raulkovcs-ux/emg_iot_device/docs/images/hub_bottom.png

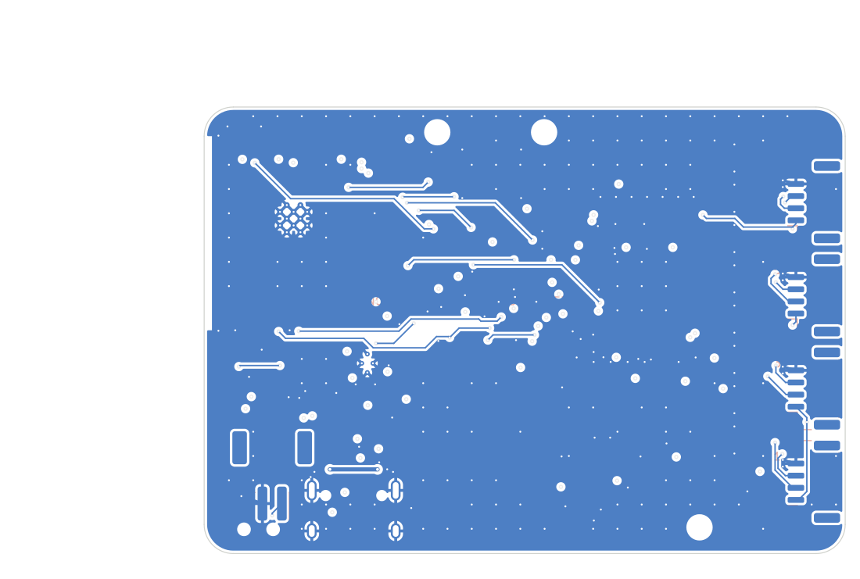
docs/images/hub_bottom.png
