raulkovcs-ux/emg_iot_device/docs/images/hub_flex_bottom.png

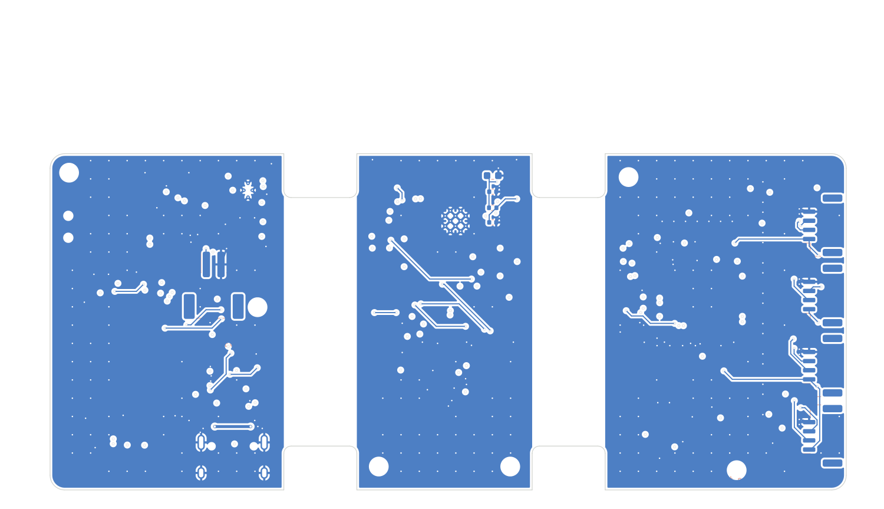
docs/images/hub_flex_bottom.png
