raulkovcs-ux/emg_iot_device/docs/images/hub_flex_schematic-2.png

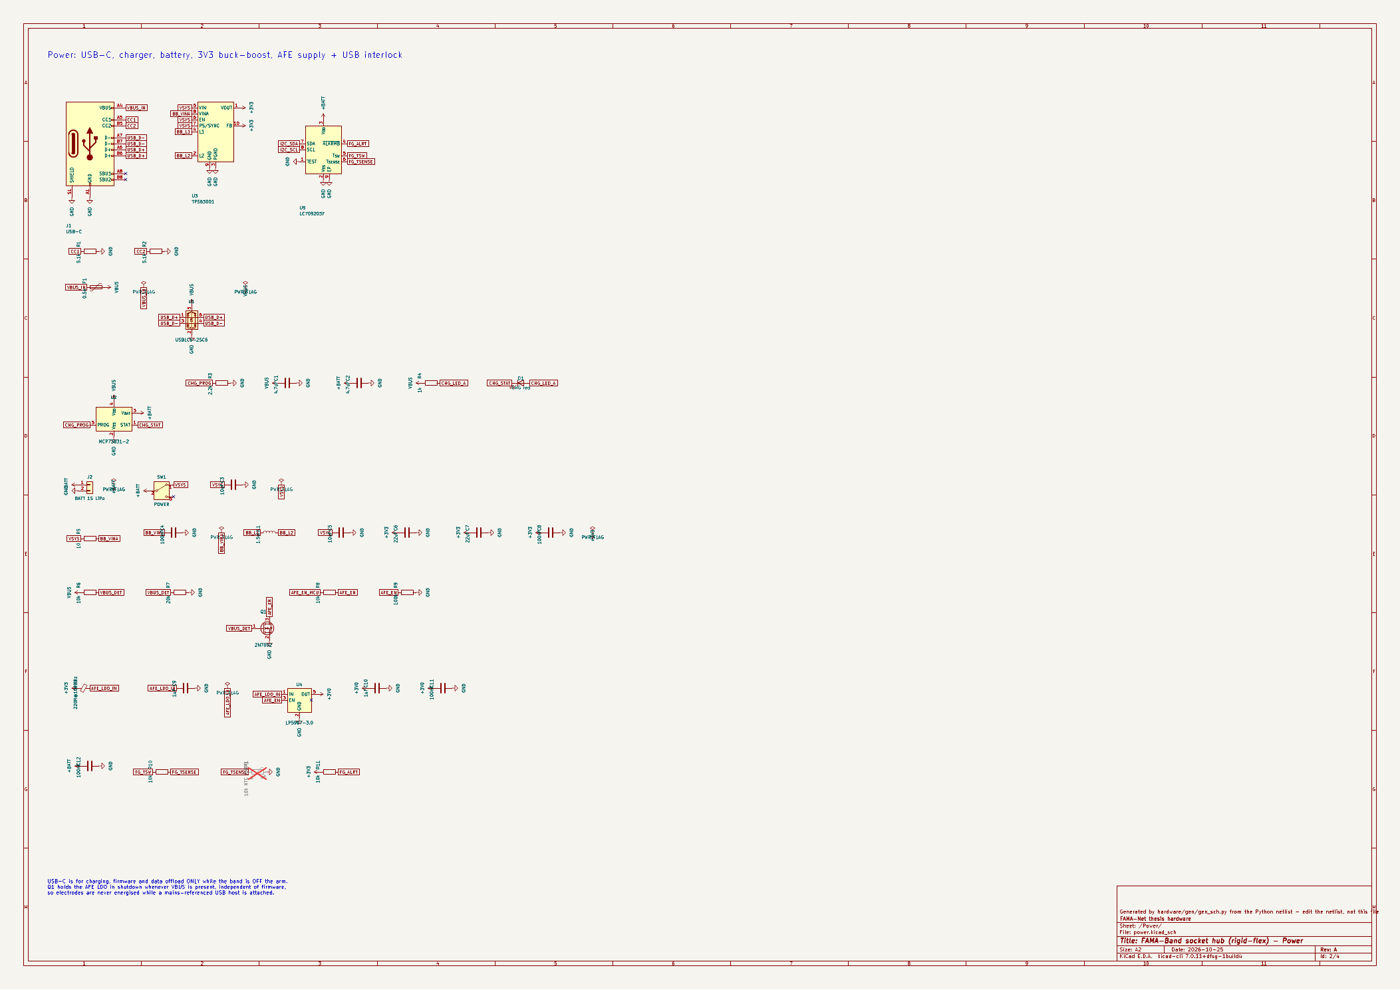
docs/images/hub_flex_schematic-2.png
