raulkovcs-ux/emg_iot_device/docs/images/hub_flex_schematic-3.png

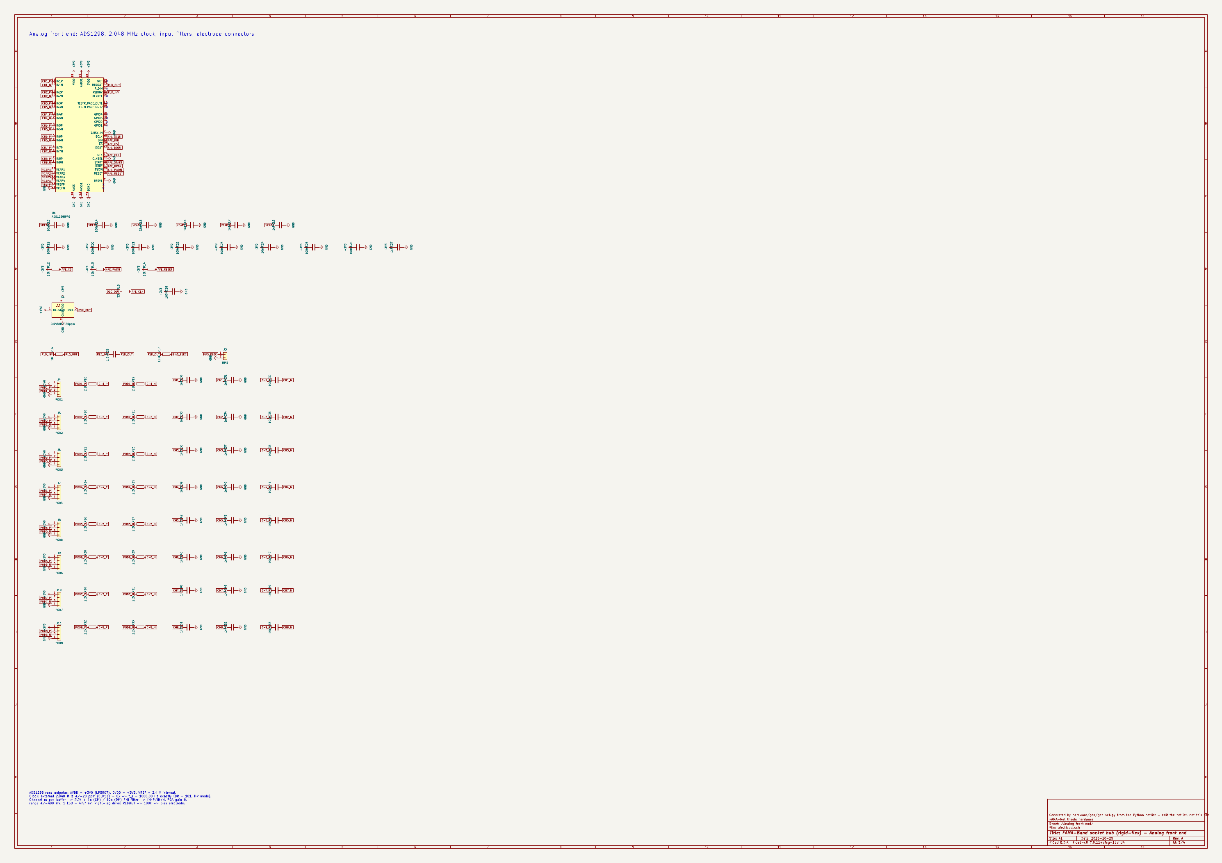
docs/images/hub_flex_schematic-3.png
