raulkovcs-ux/emg_iot_device/docs/images/hub_flex_schematic-4.png

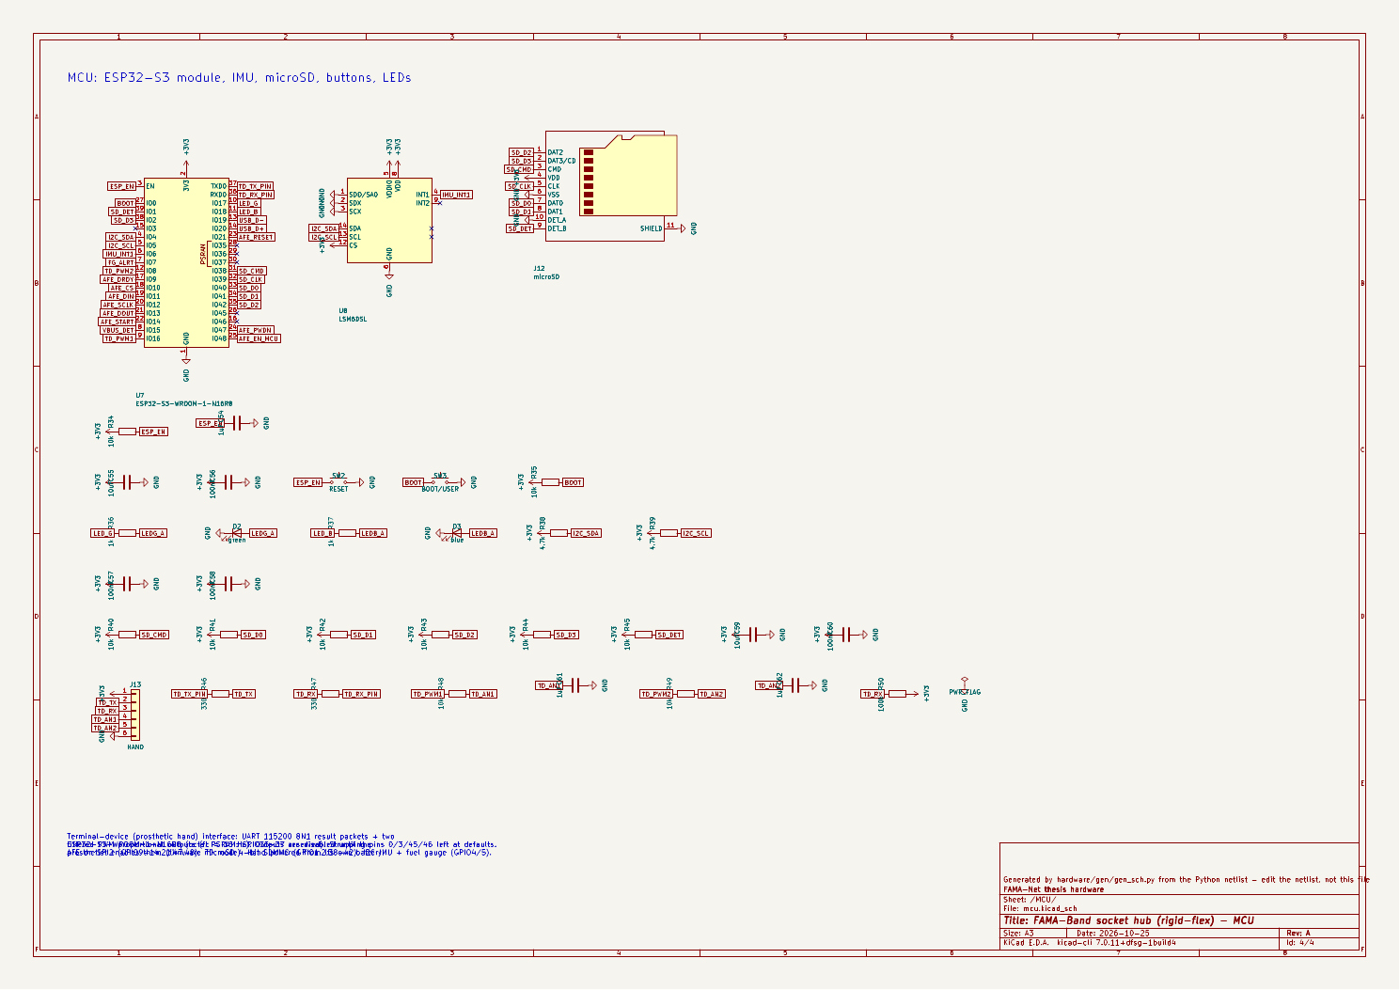
docs/images/hub_flex_schematic-4.png
