raulkovcs-ux/emg_iot_device/docs/images/hub_in2.png

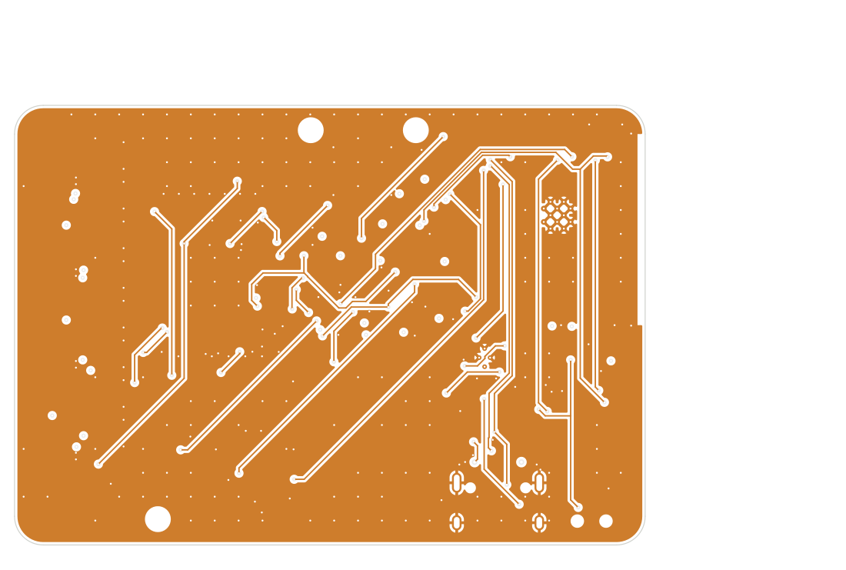
docs/images/hub_in2.png
