raulkovcs-ux/emg_iot_device/docs/images/pod_schematic-1.png

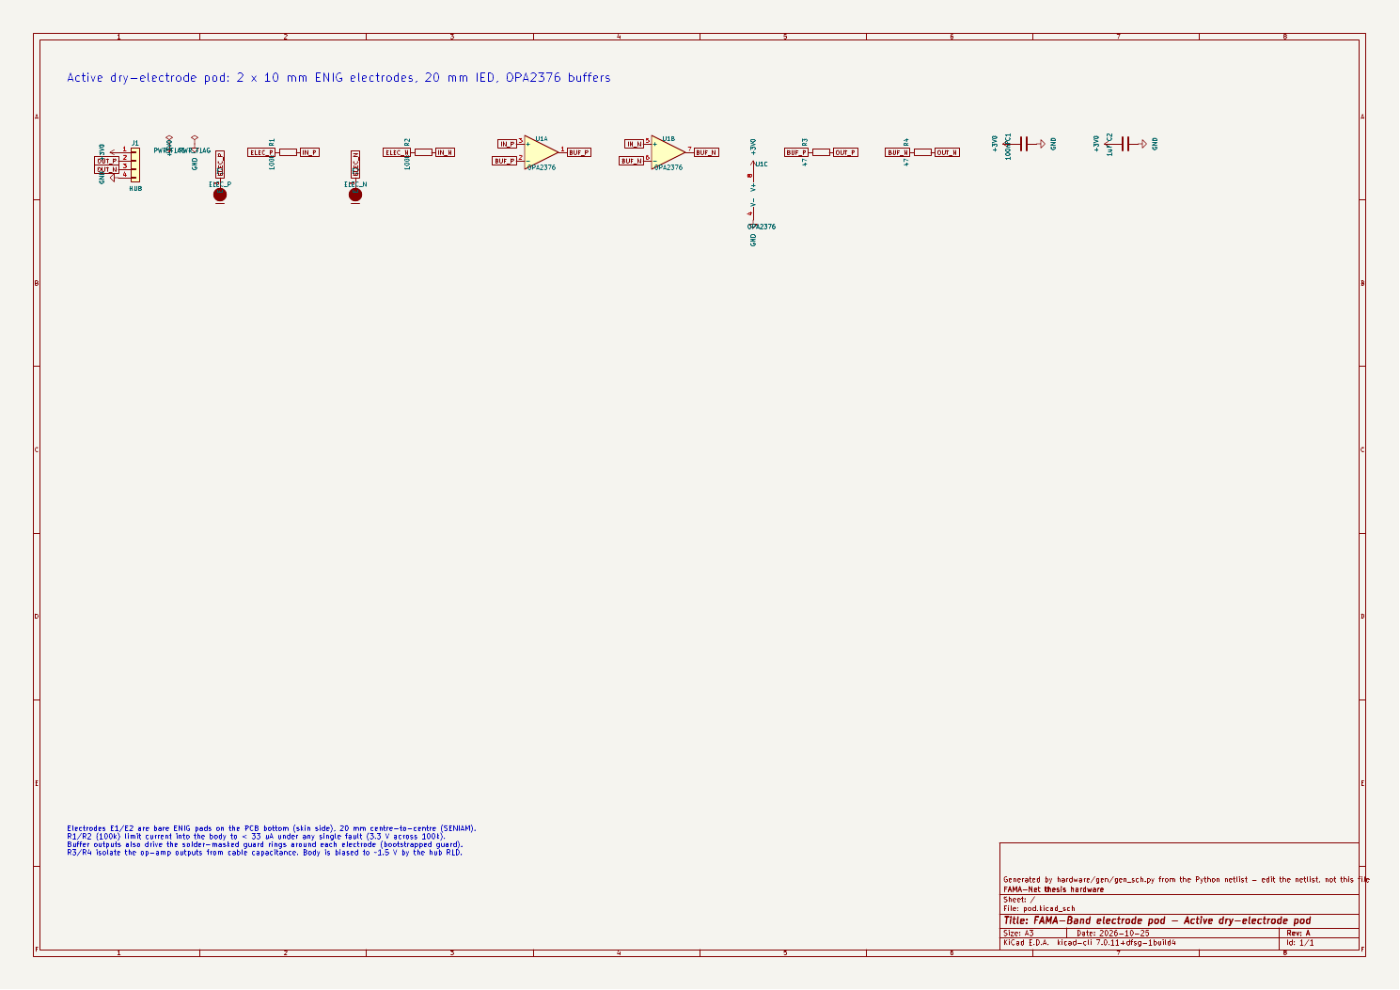
docs/images/pod_schematic-1.png
