raulkovcs-ux/emg_iot_device/docs/images/pod_skin_side.png

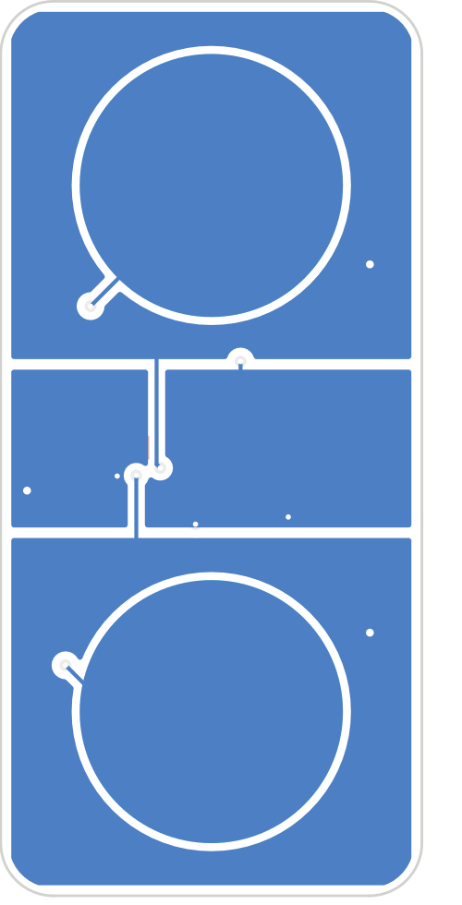
docs/images/pod_skin_side.png
