raulkovcs-ux/emg_iot_device/docs/images/pod_top.png

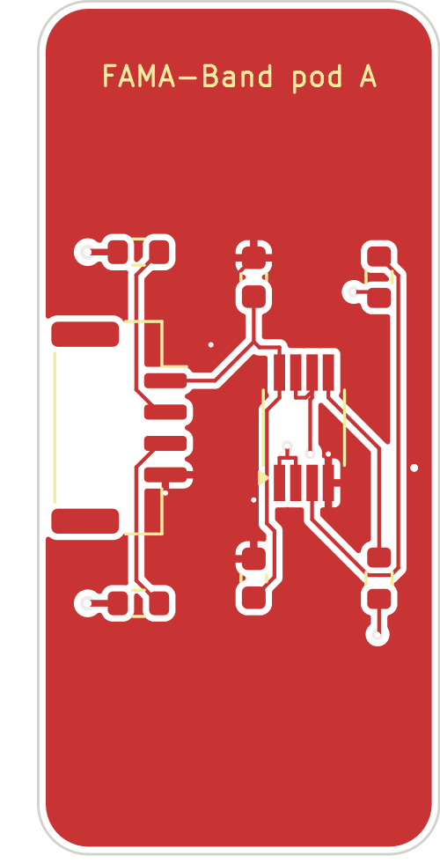
docs/images/pod_top.png
