raulkovcs-ux/emg_iot_device/hardware/fab/hub/hub.step

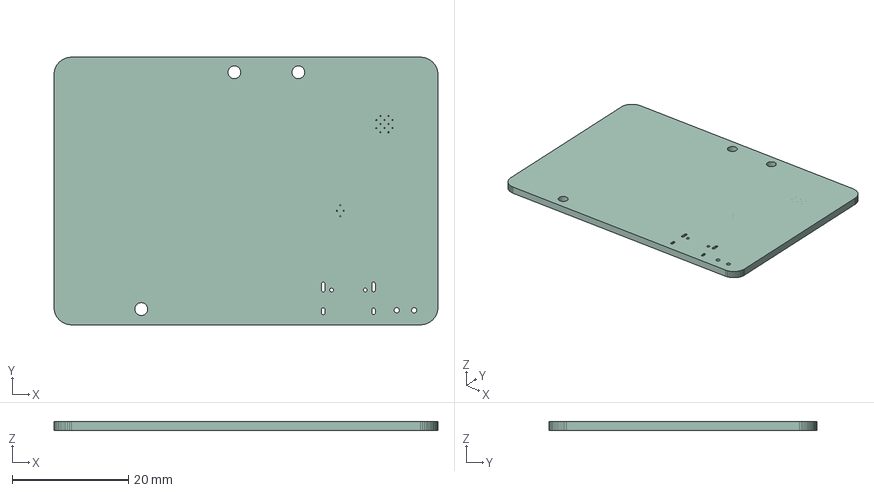
[picture p21: CAD file, 2026-10-24]
hardware/fab/hub/hub.step
66.0 x 46.0 x 1.60 mm
