raulkovcs-ux/emg_iot_device/hardware/fab/hub_flex/hub_flex.step

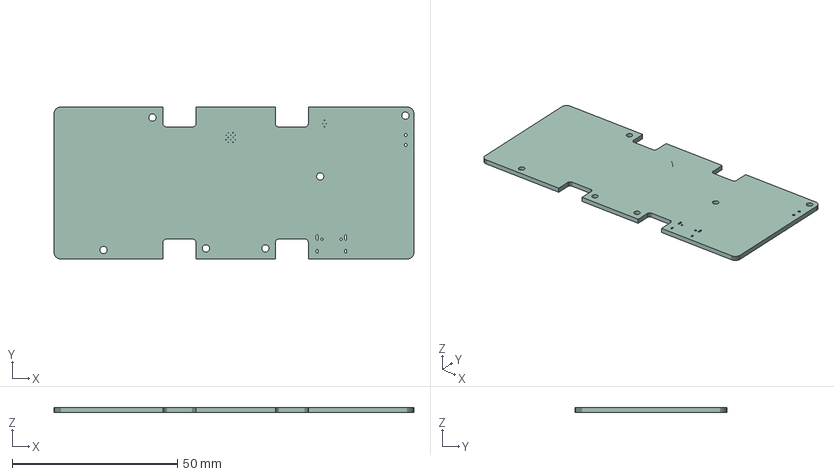
[picture p22: CAD file, 2026-10-25]
hardware/fab/hub_flex/hub_flex.step
109.0 x 46.0 x 1.60 mm
