raulkovcs-ux/emg_iot_device/hardware/fab/pod/pod.step

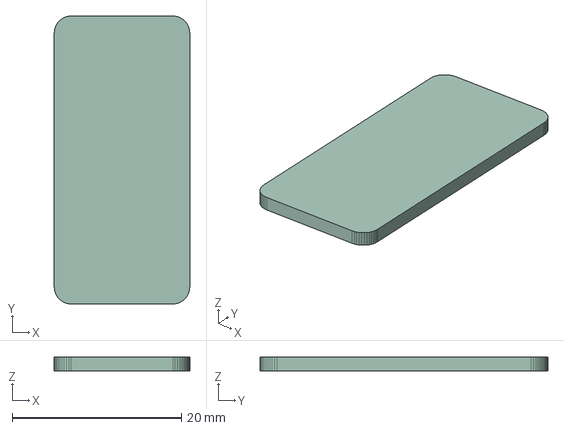
[picture p23: CAD file, 2026-10-24]
hardware/fab/pod/pod.step
16.0 x 34.0 x 1.60 mm
