raulkovcs-ux/emg_iot_device/mechanical/stl/socket_service_door.stl

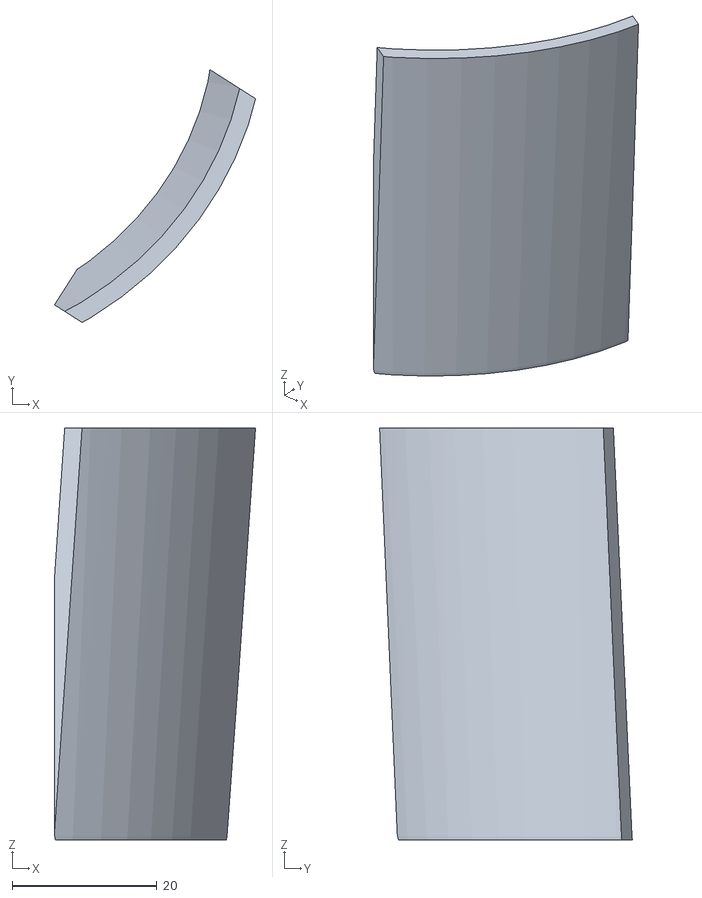
[picture p24: CAD file, 2026-10-25]
mechanical/stl/socket_service_door.stl
27.8 x 35.0 x 57.0
