raulkovcs-ux/emg_iot_device/mechanical/stl/socket_hub_carrier.stl

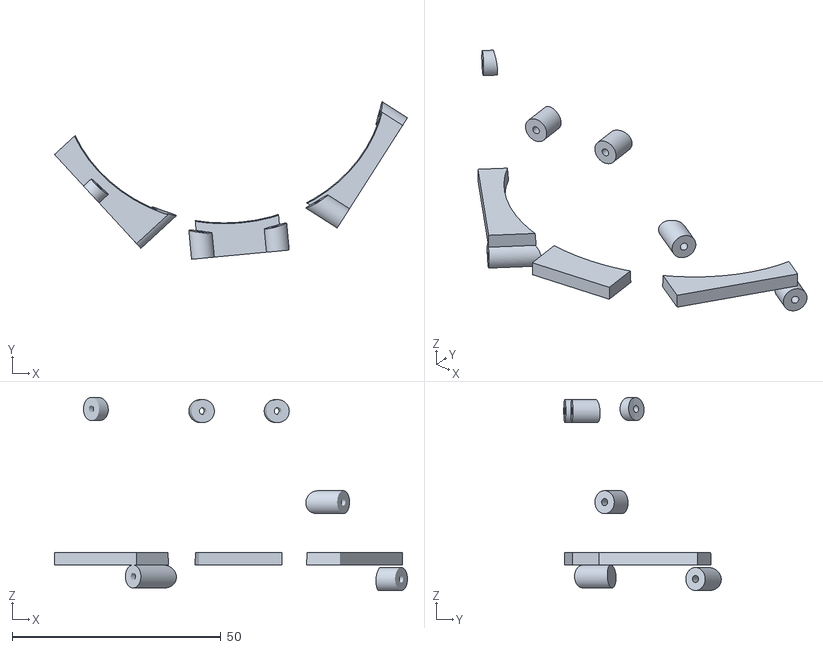
[picture p25: CAD file, 2026-10-25]
mechanical/stl/socket_hub_carrier.stl
84.5 x 37.7 x 46.2
