raulkovcs-ux/emg_iot_device/mechanical/stl/socket_inner_socket.stl

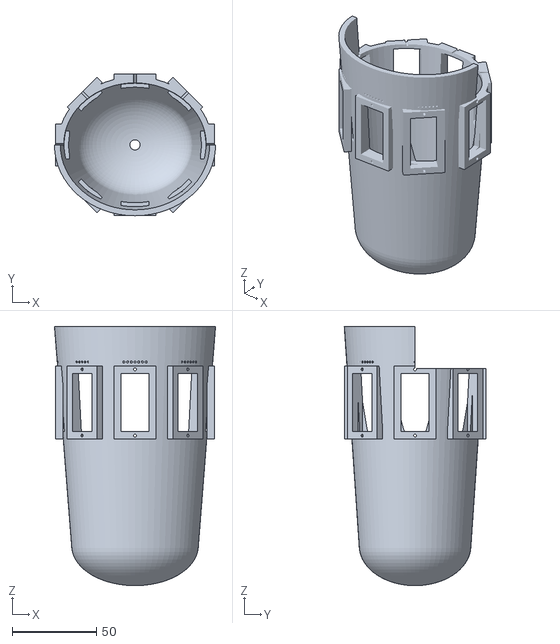
[picture p26: CAD file, 2026-10-25]
mechanical/stl/socket_inner_socket.stl
95.4 x 83.8 x 153.4
