raulkovcs-ux/emg_iot_device/mechanical/stl/socket_frame_posterior.stl

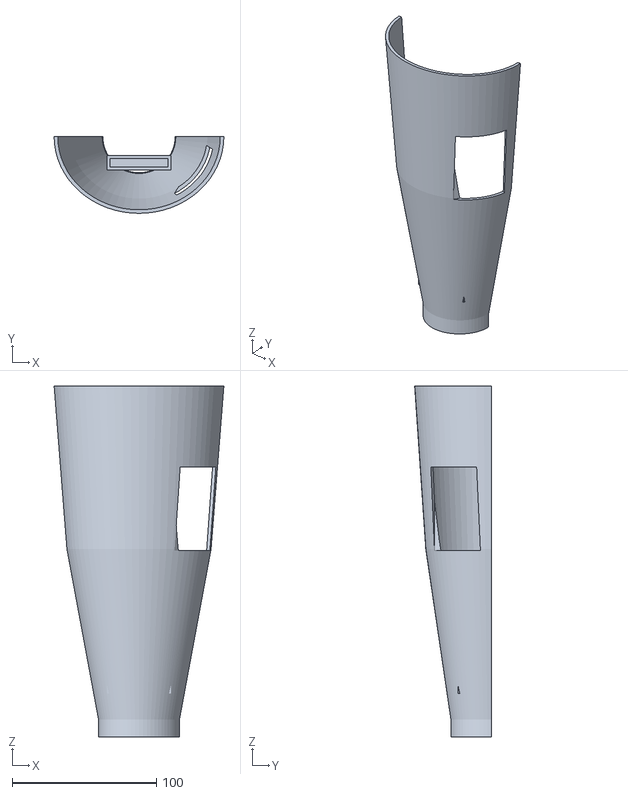
[picture p27: CAD file, 2026-10-25]
mechanical/stl/socket_frame_posterior.stl
117.5 x 53.1 x 243.0
