raulkovcs-ux/emg_iot_device/mechanical/stl/socket_cartridge.stl

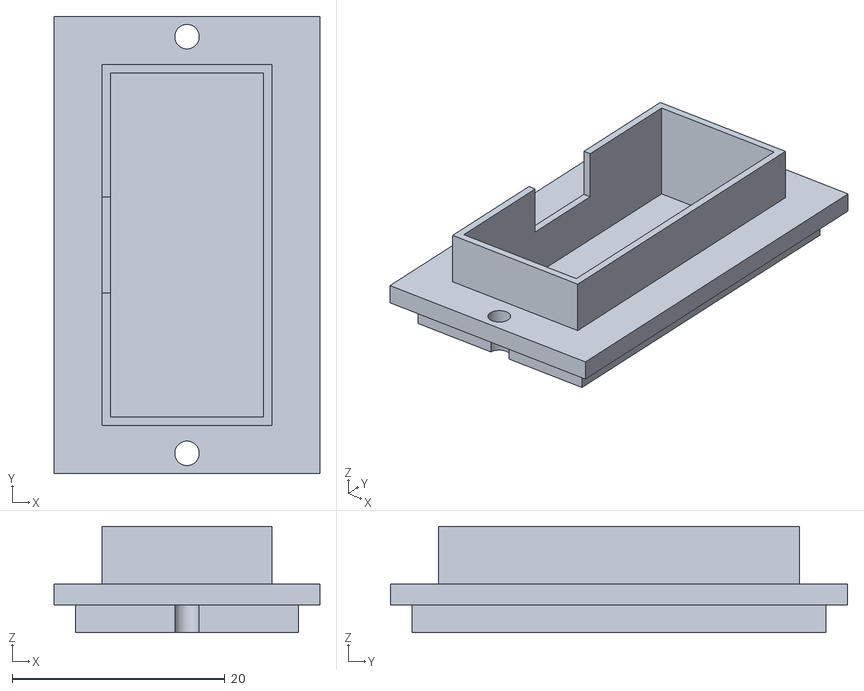
[picture p28: CAD file, 2026-10-25]
mechanical/stl/socket_cartridge.stl
25.0 x 43.0 x 10.0
