raulkovcs-ux/emg_iot_device/mechanical/stl/hub_base.stl

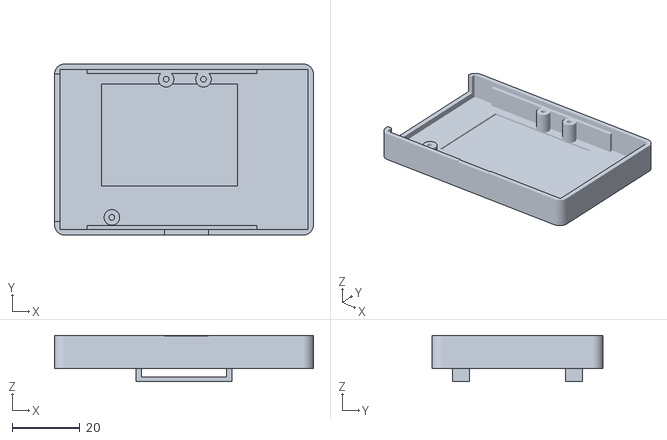
[picture p30: CAD file, 2026-10-24]
mechanical/stl/hub_base.stl
76.3 x 50.4 x 13.6
