raulkovcs-ux/emg_iot_device/mechanical/stl/pod.stl

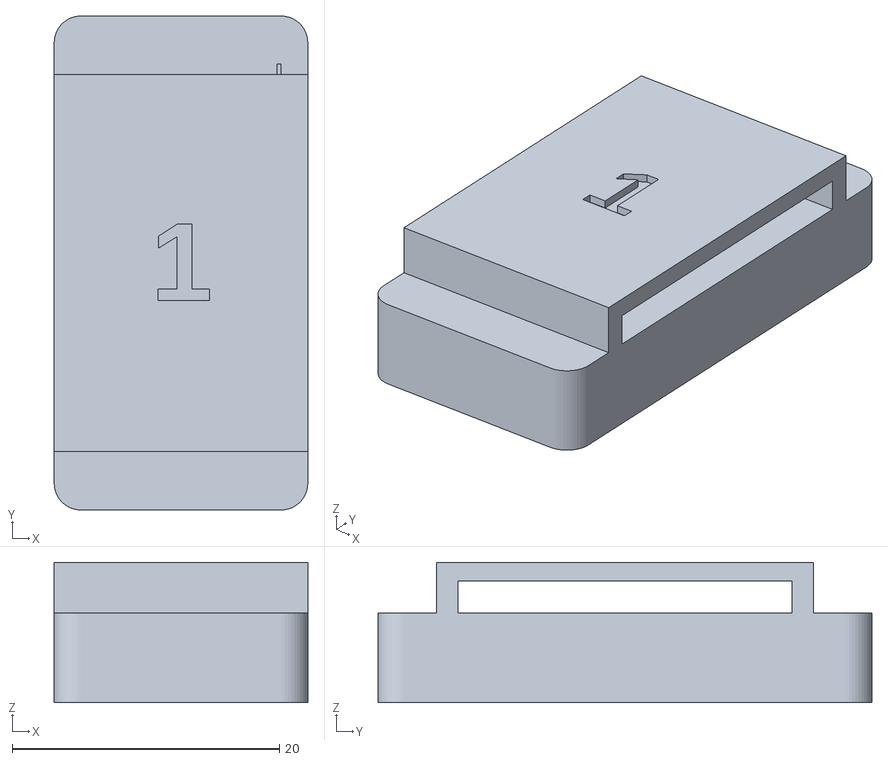
[picture p31: CAD file, 2026-10-24]
mechanical/stl/pod.stl
19.0 x 37.0 x 10.5
