raulkovcs-ux/emg_iot_device/mechanical/stl/hub_lid.stl

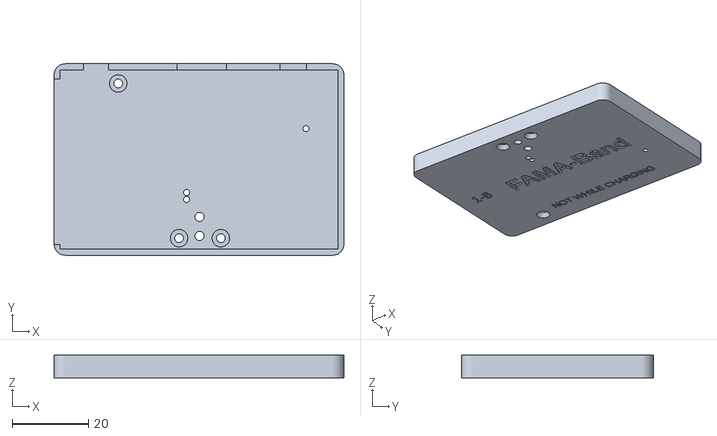
[picture p32: CAD file, 2026-10-24]
mechanical/stl/hub_lid.stl
76.3 x 50.4 x 6.00
