raulkovcs-ux/emg_iot_device/docs/images/hub_assembly_top.png

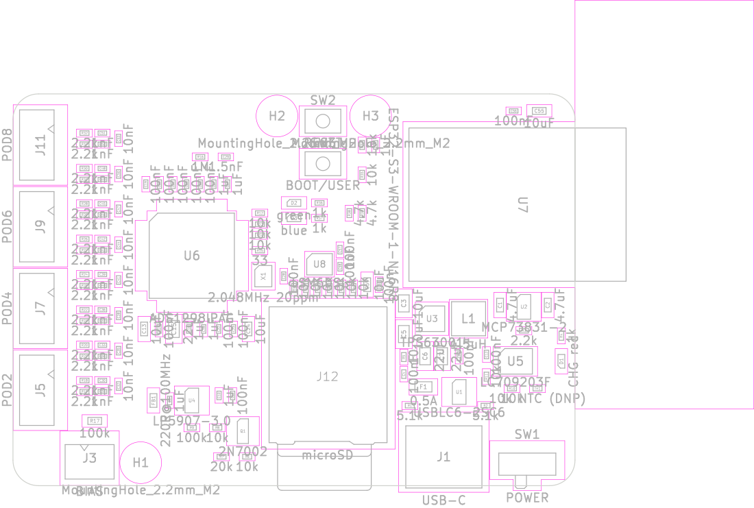
docs/images/hub_assembly_top.png
