raulkovcs-ux/emg_iot_device/mechanical/renders/assembly_end.png

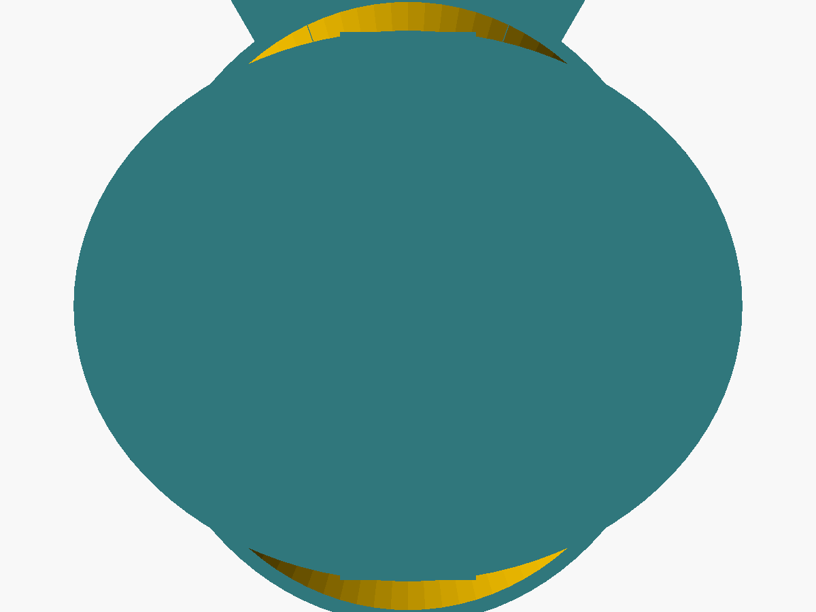
mechanical/renders/assembly_end.png
