raulkovcs-ux/emg_iot_device/mechanical/renders/assembly_exploded.png

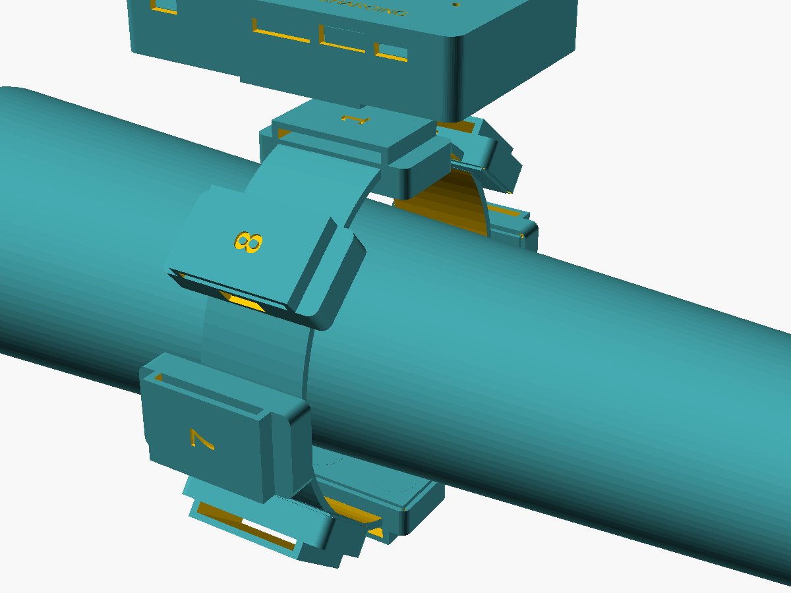
mechanical/renders/assembly_exploded.png
