raulkovcs-ux/emg_iot_device/hardware/docs/hub_schematic.pdf

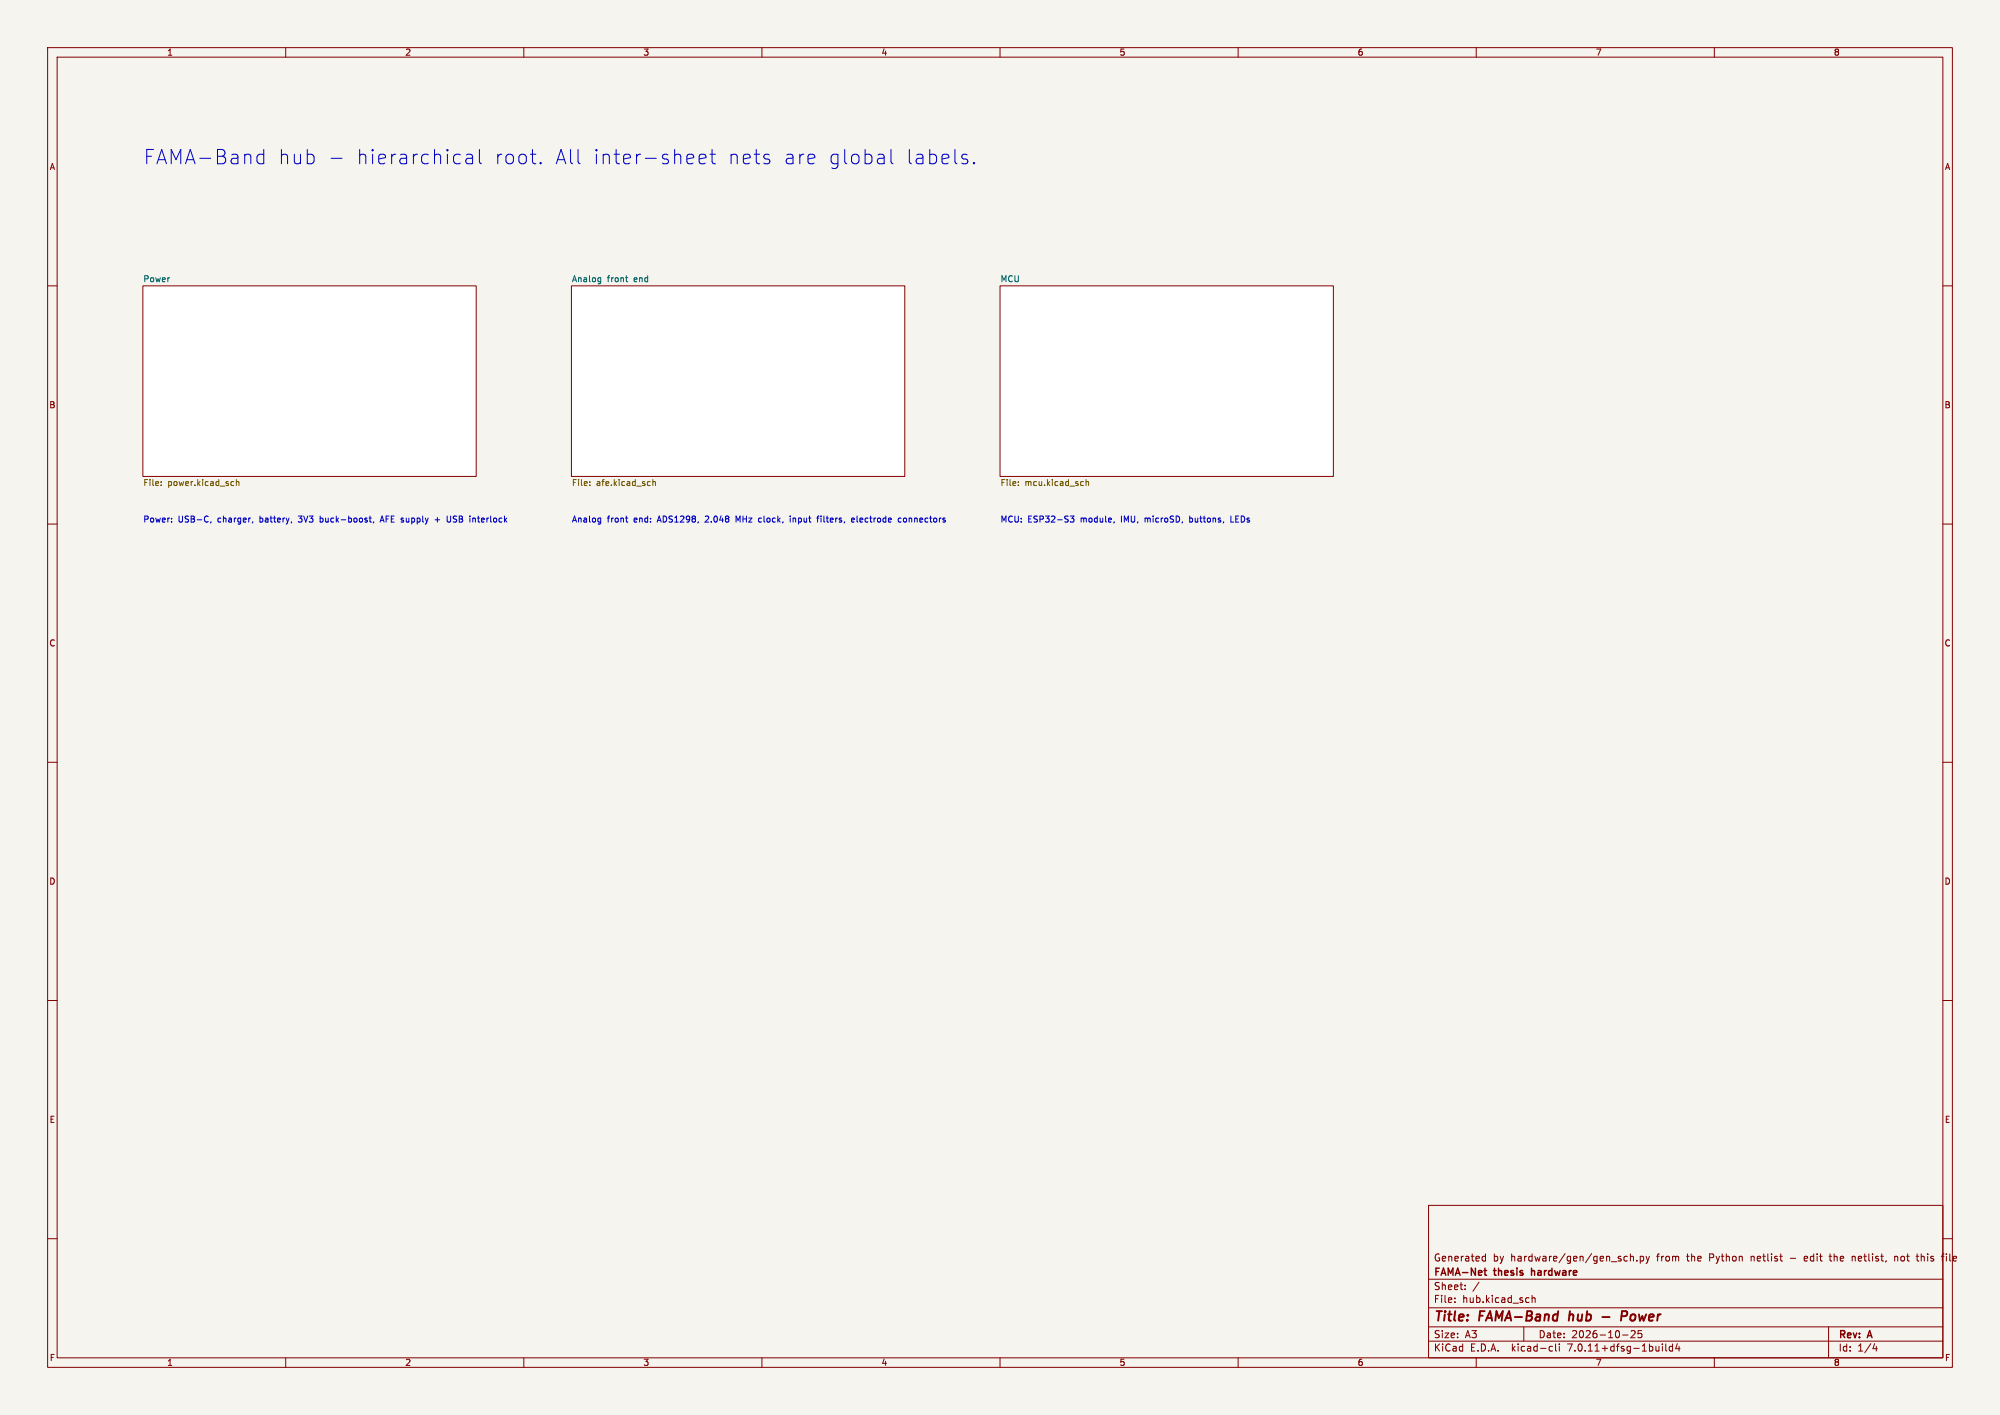
[picture p36: page 1]

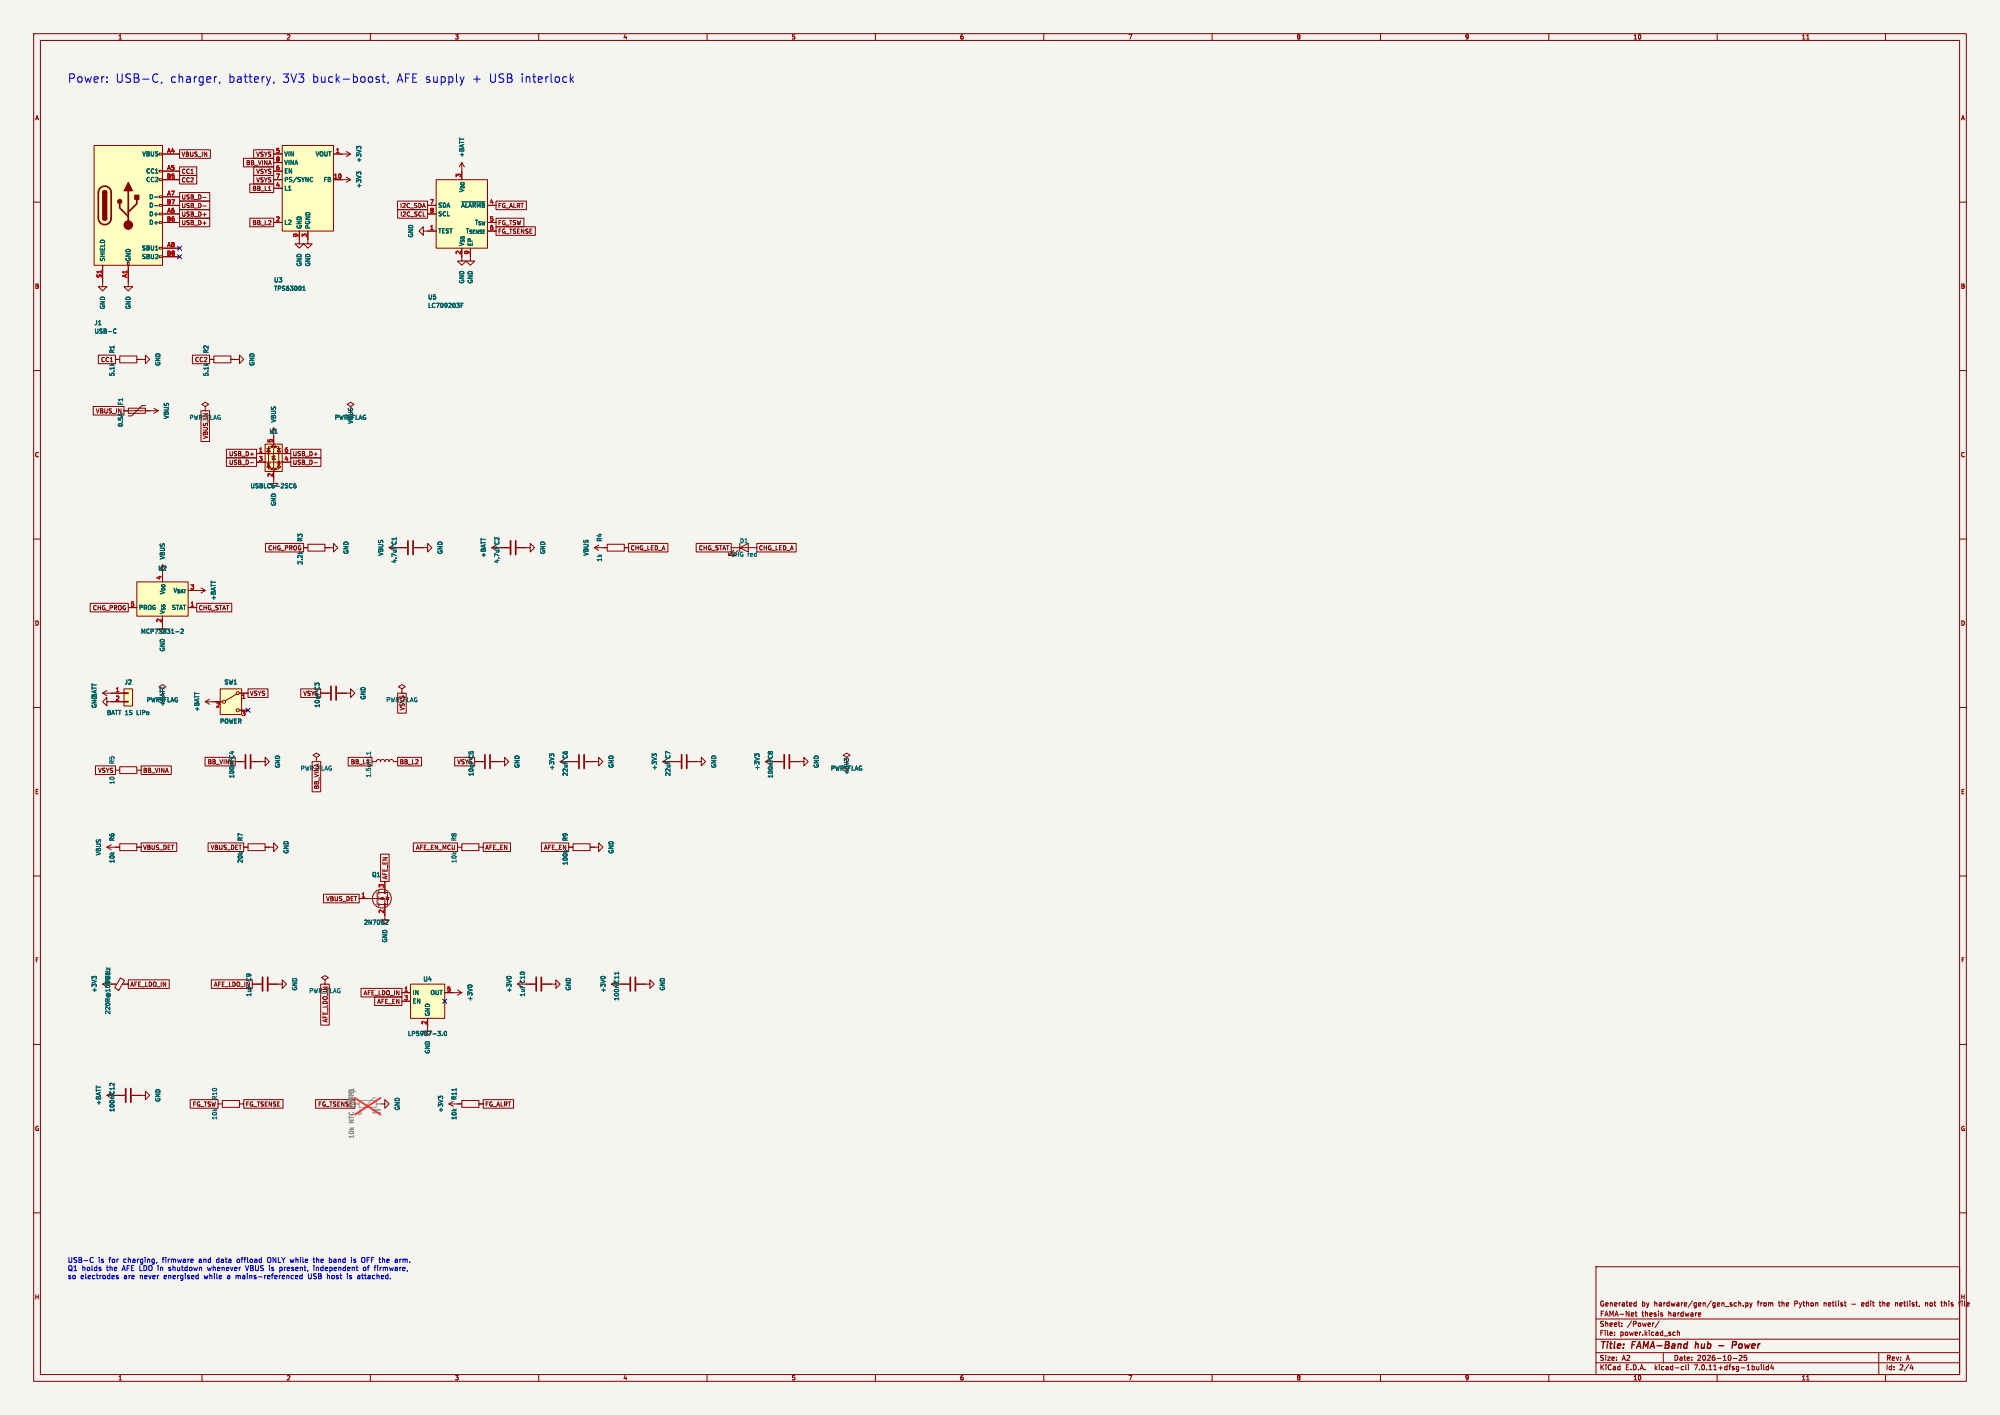
[picture p37: page 2]

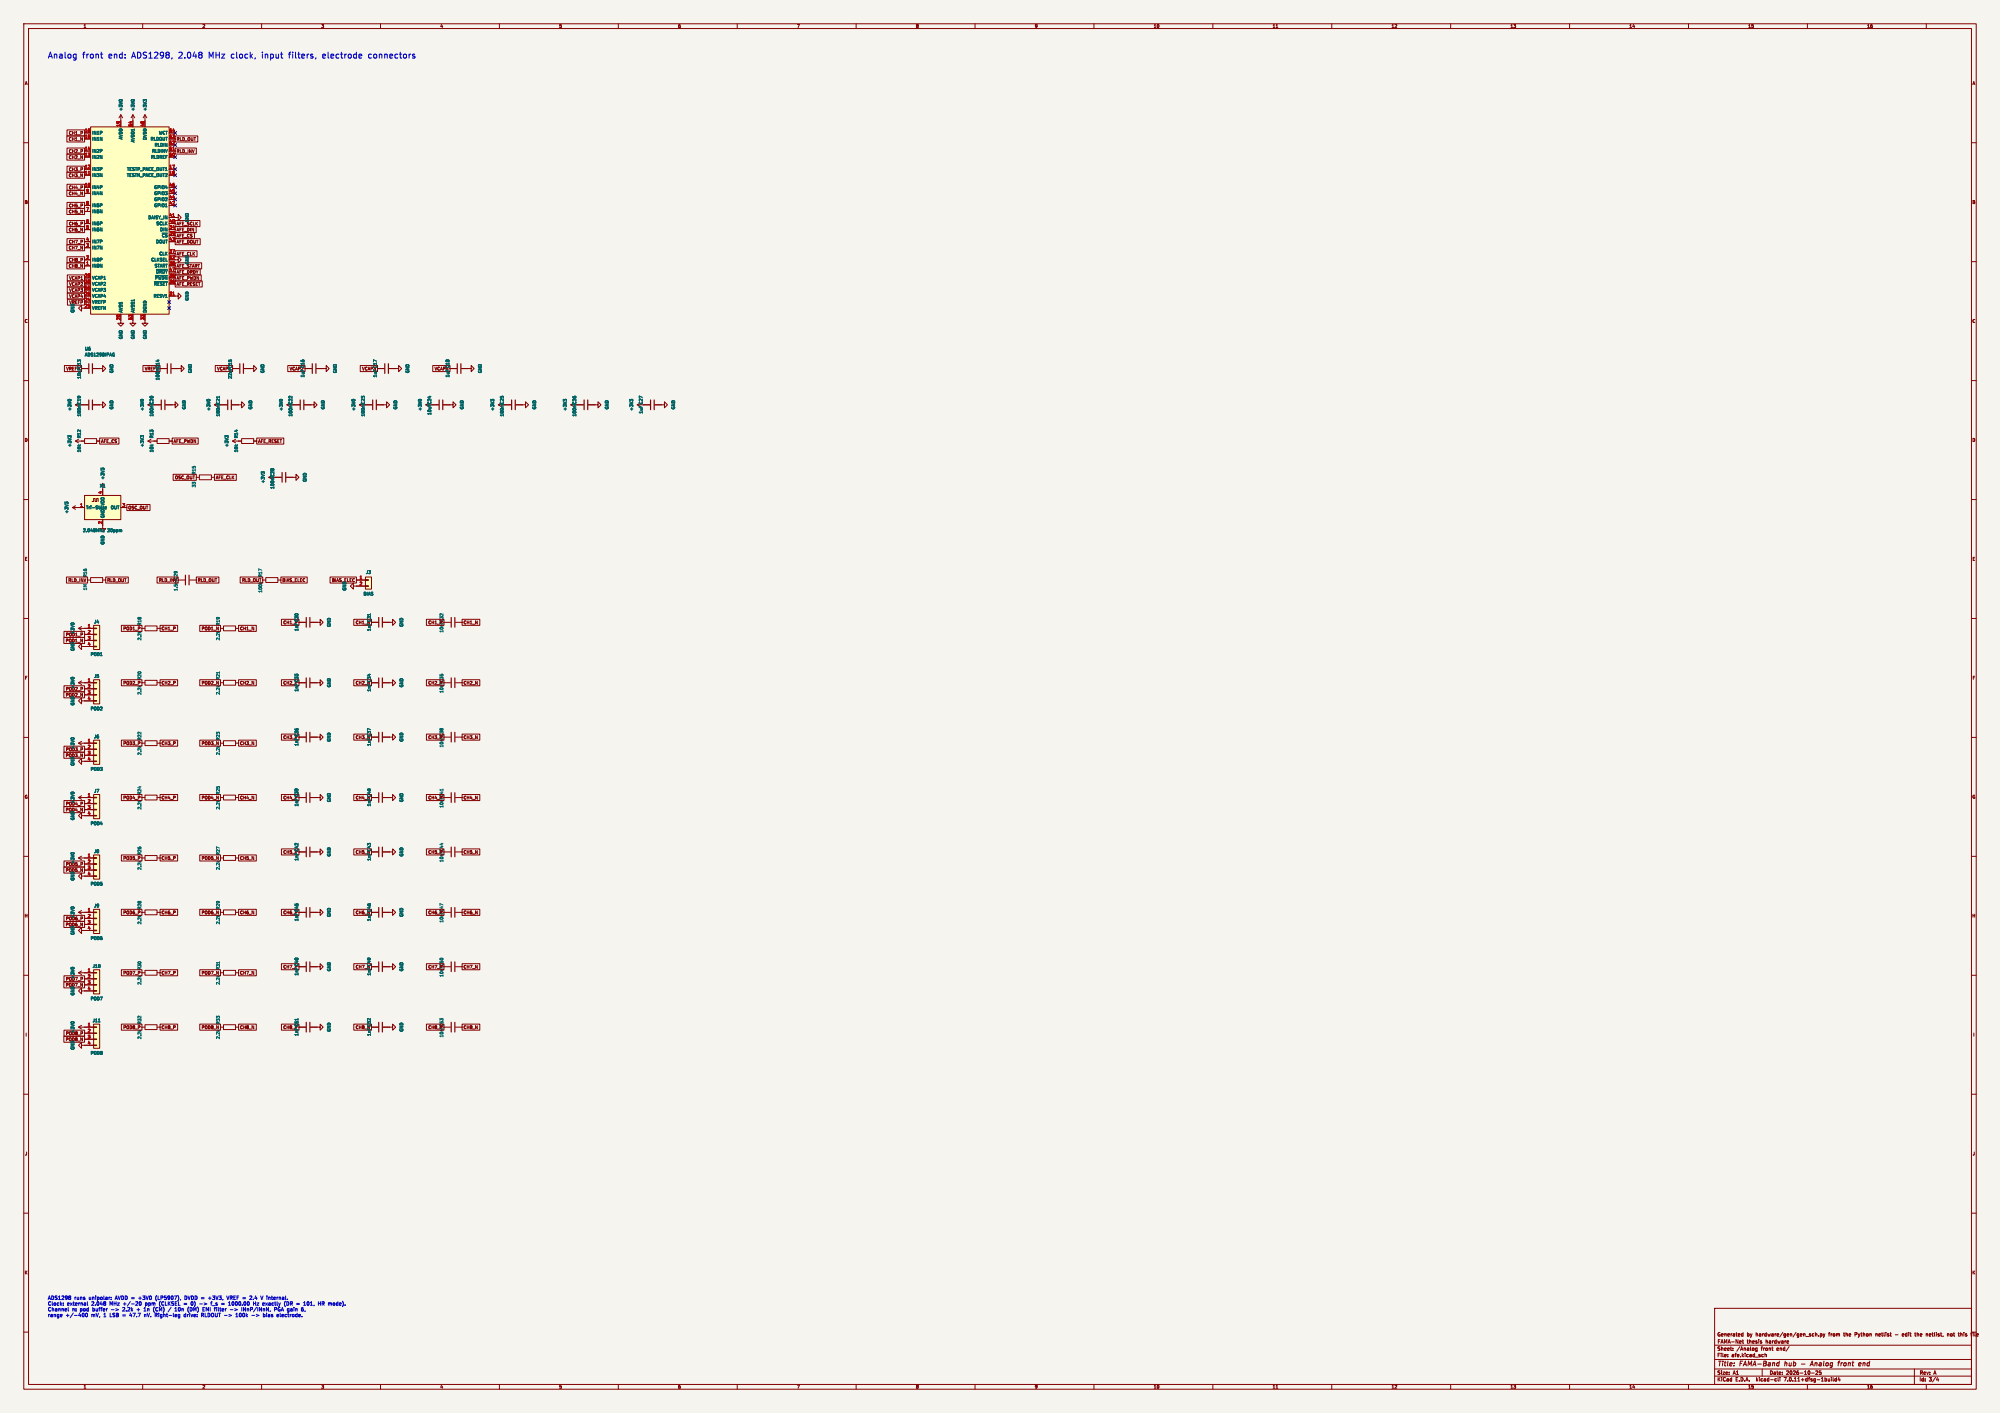
[picture p38: page 3]

Id: 3/4 Title: FAMA-Band hub - Analog front end

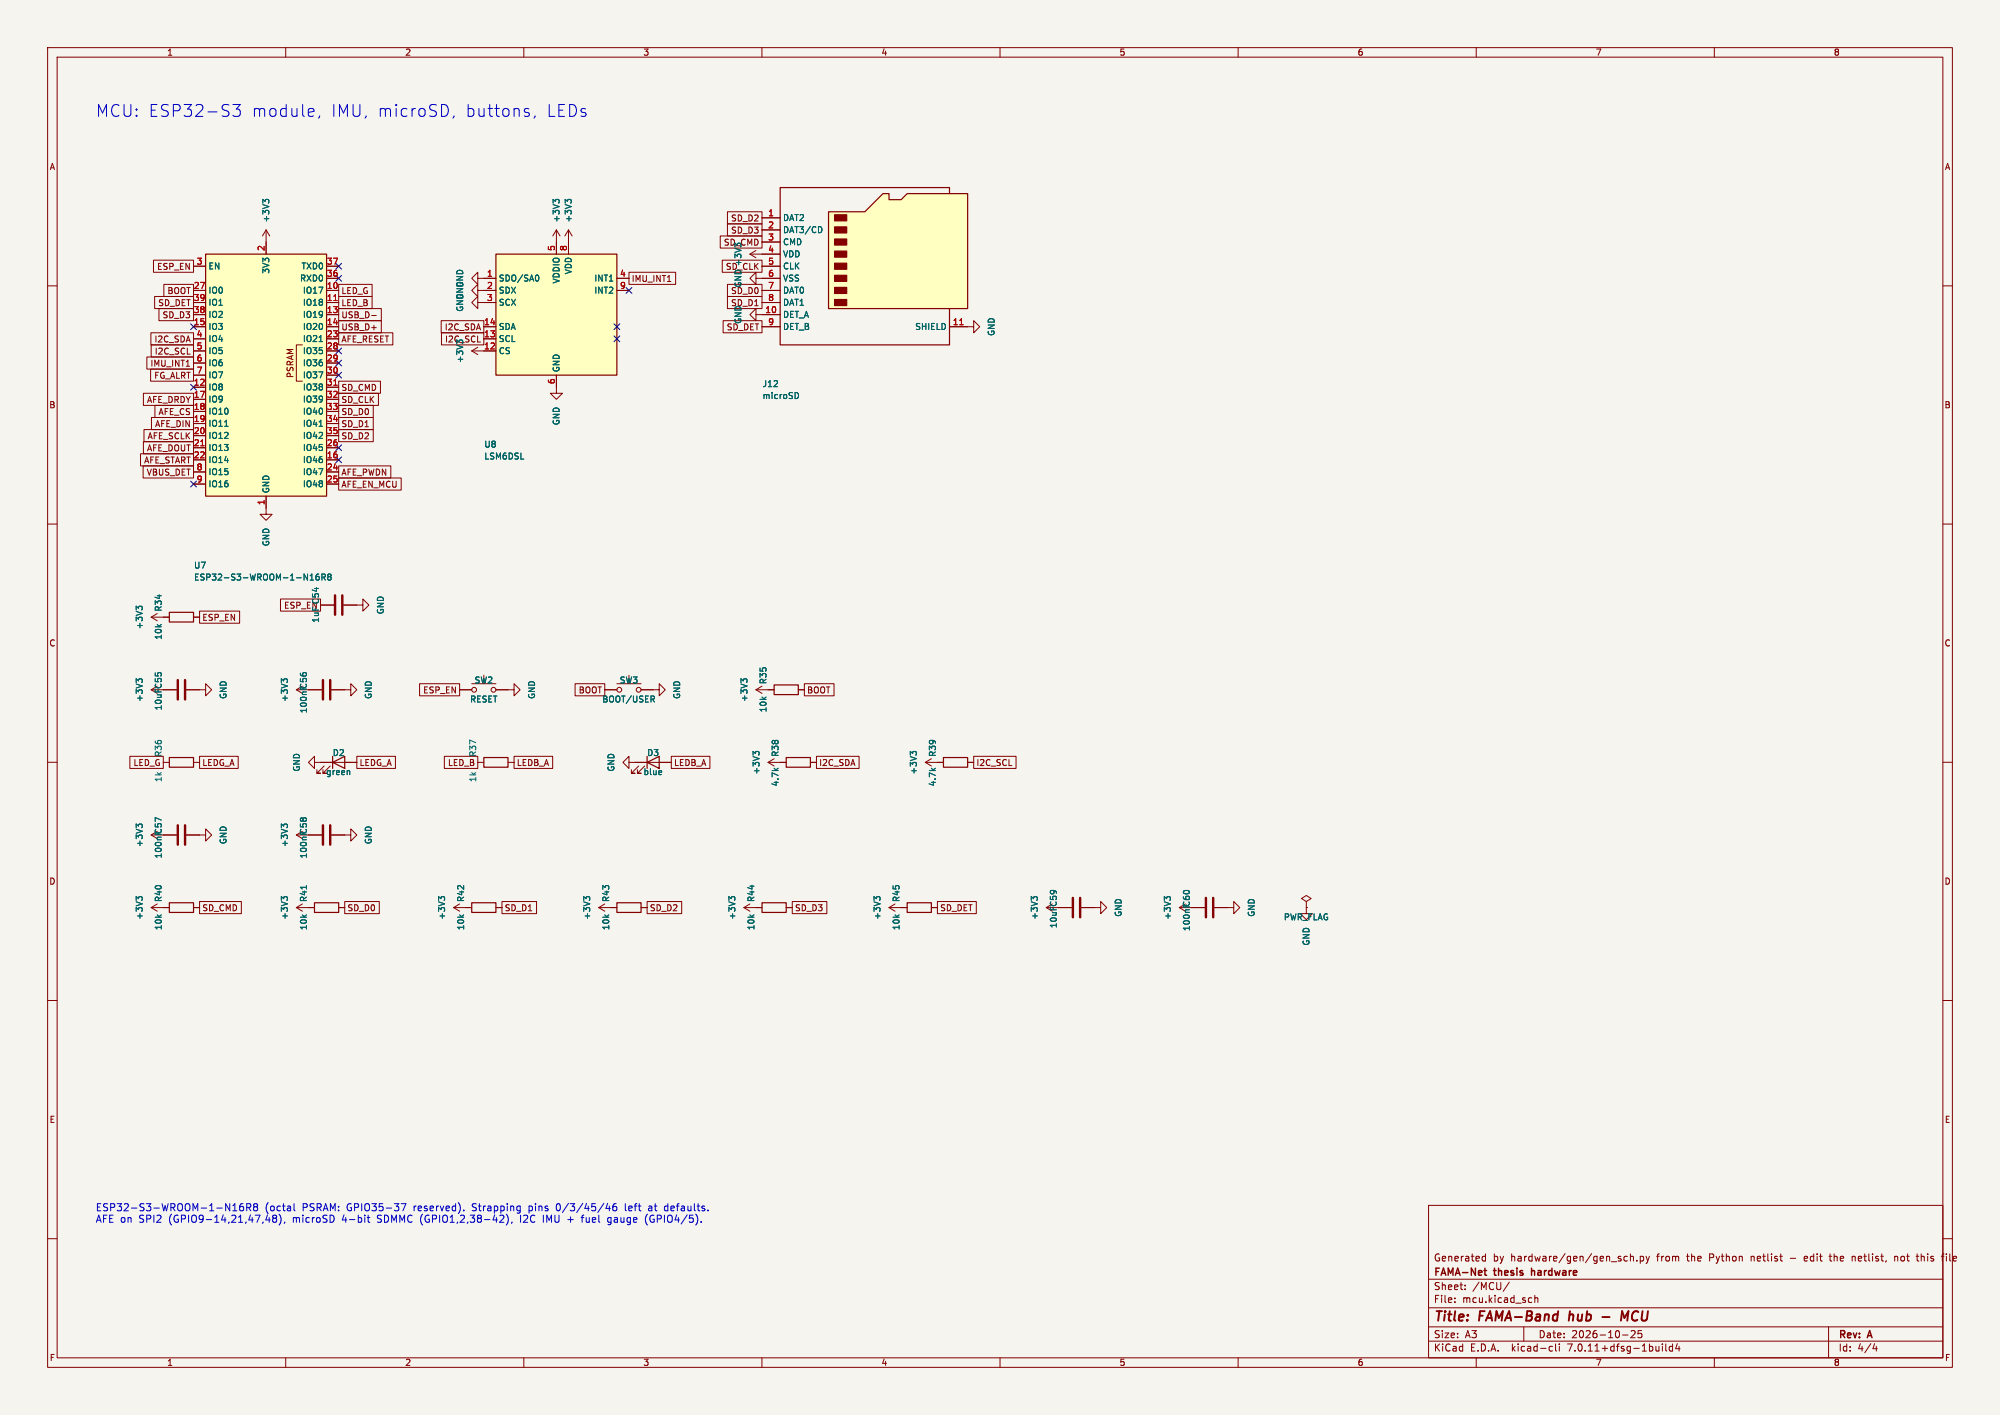
[picture p39: page 4]

LSM6DSL GND +3V3 GND PSRAM GND

Id: 4/4 Title: FAMA-Band hub - MCU
