raulkovcs-ux/emg_iot_device/hardware/fab/hub_flex/hub_flex_fab_drawing.pdf

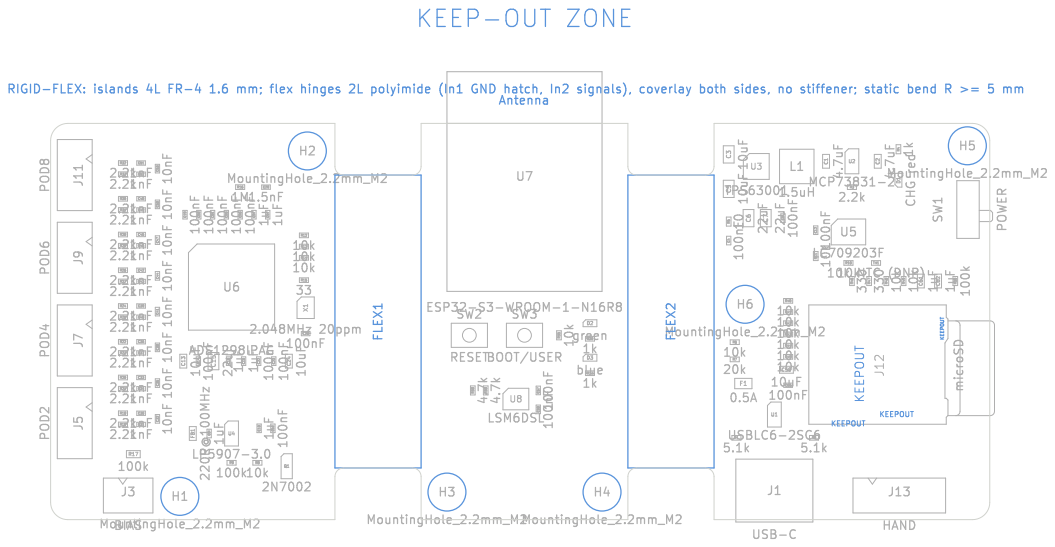
[picture p40: page 1]

Id: 1/1 Title: File: hub_flex.kicad_pcb Sheet:
