raulkovcs-ux/emg_iot_device/hardware/docs/hub_flex_schematic.pdf

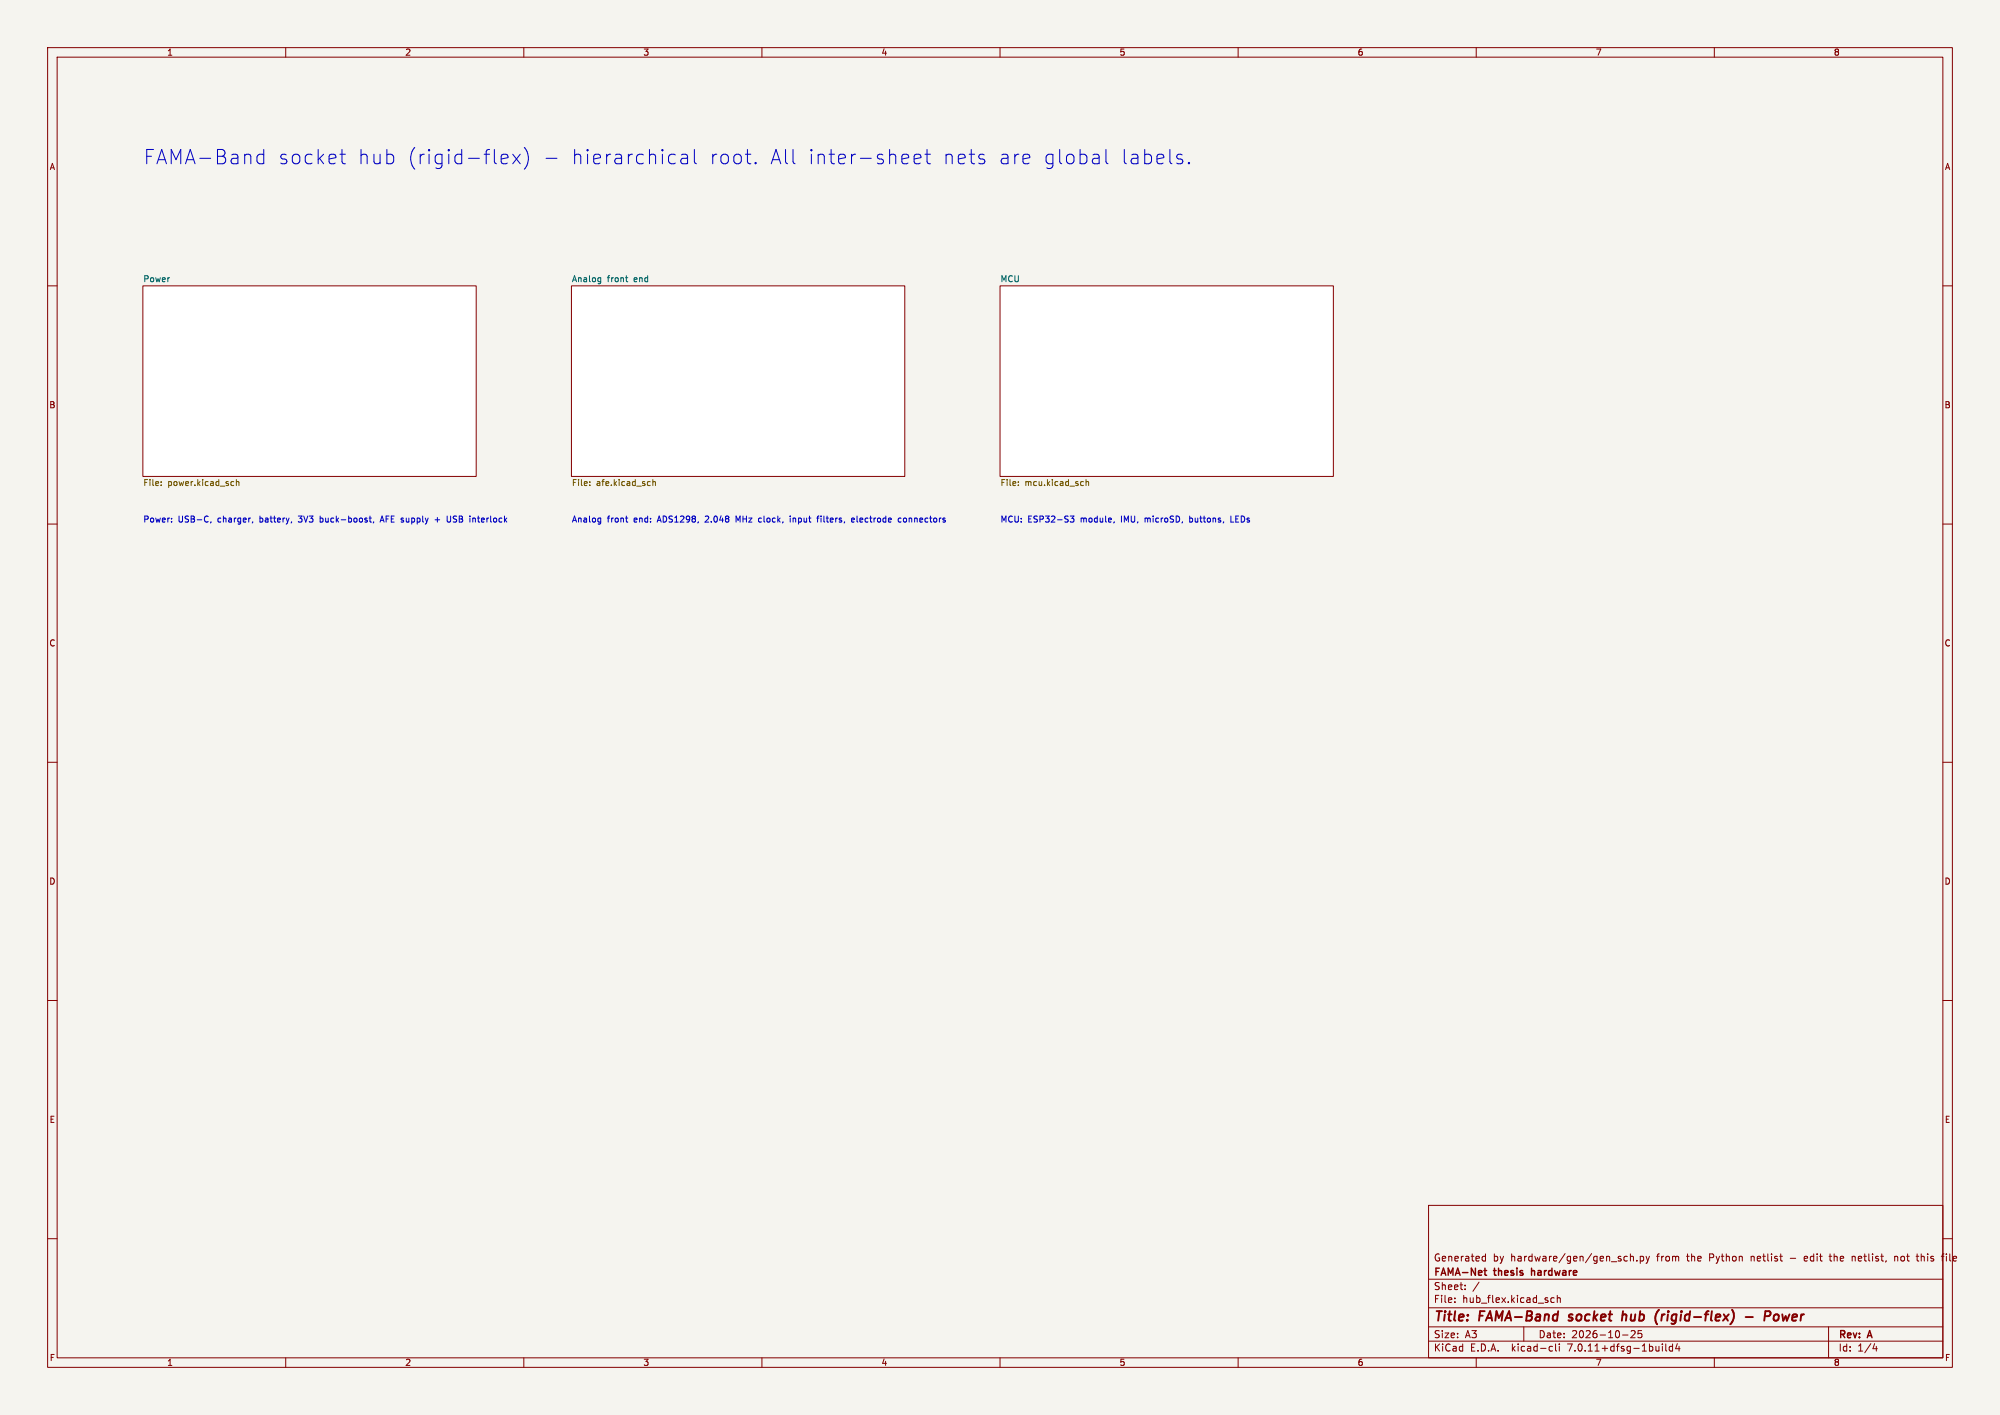
[picture p41: page 1]

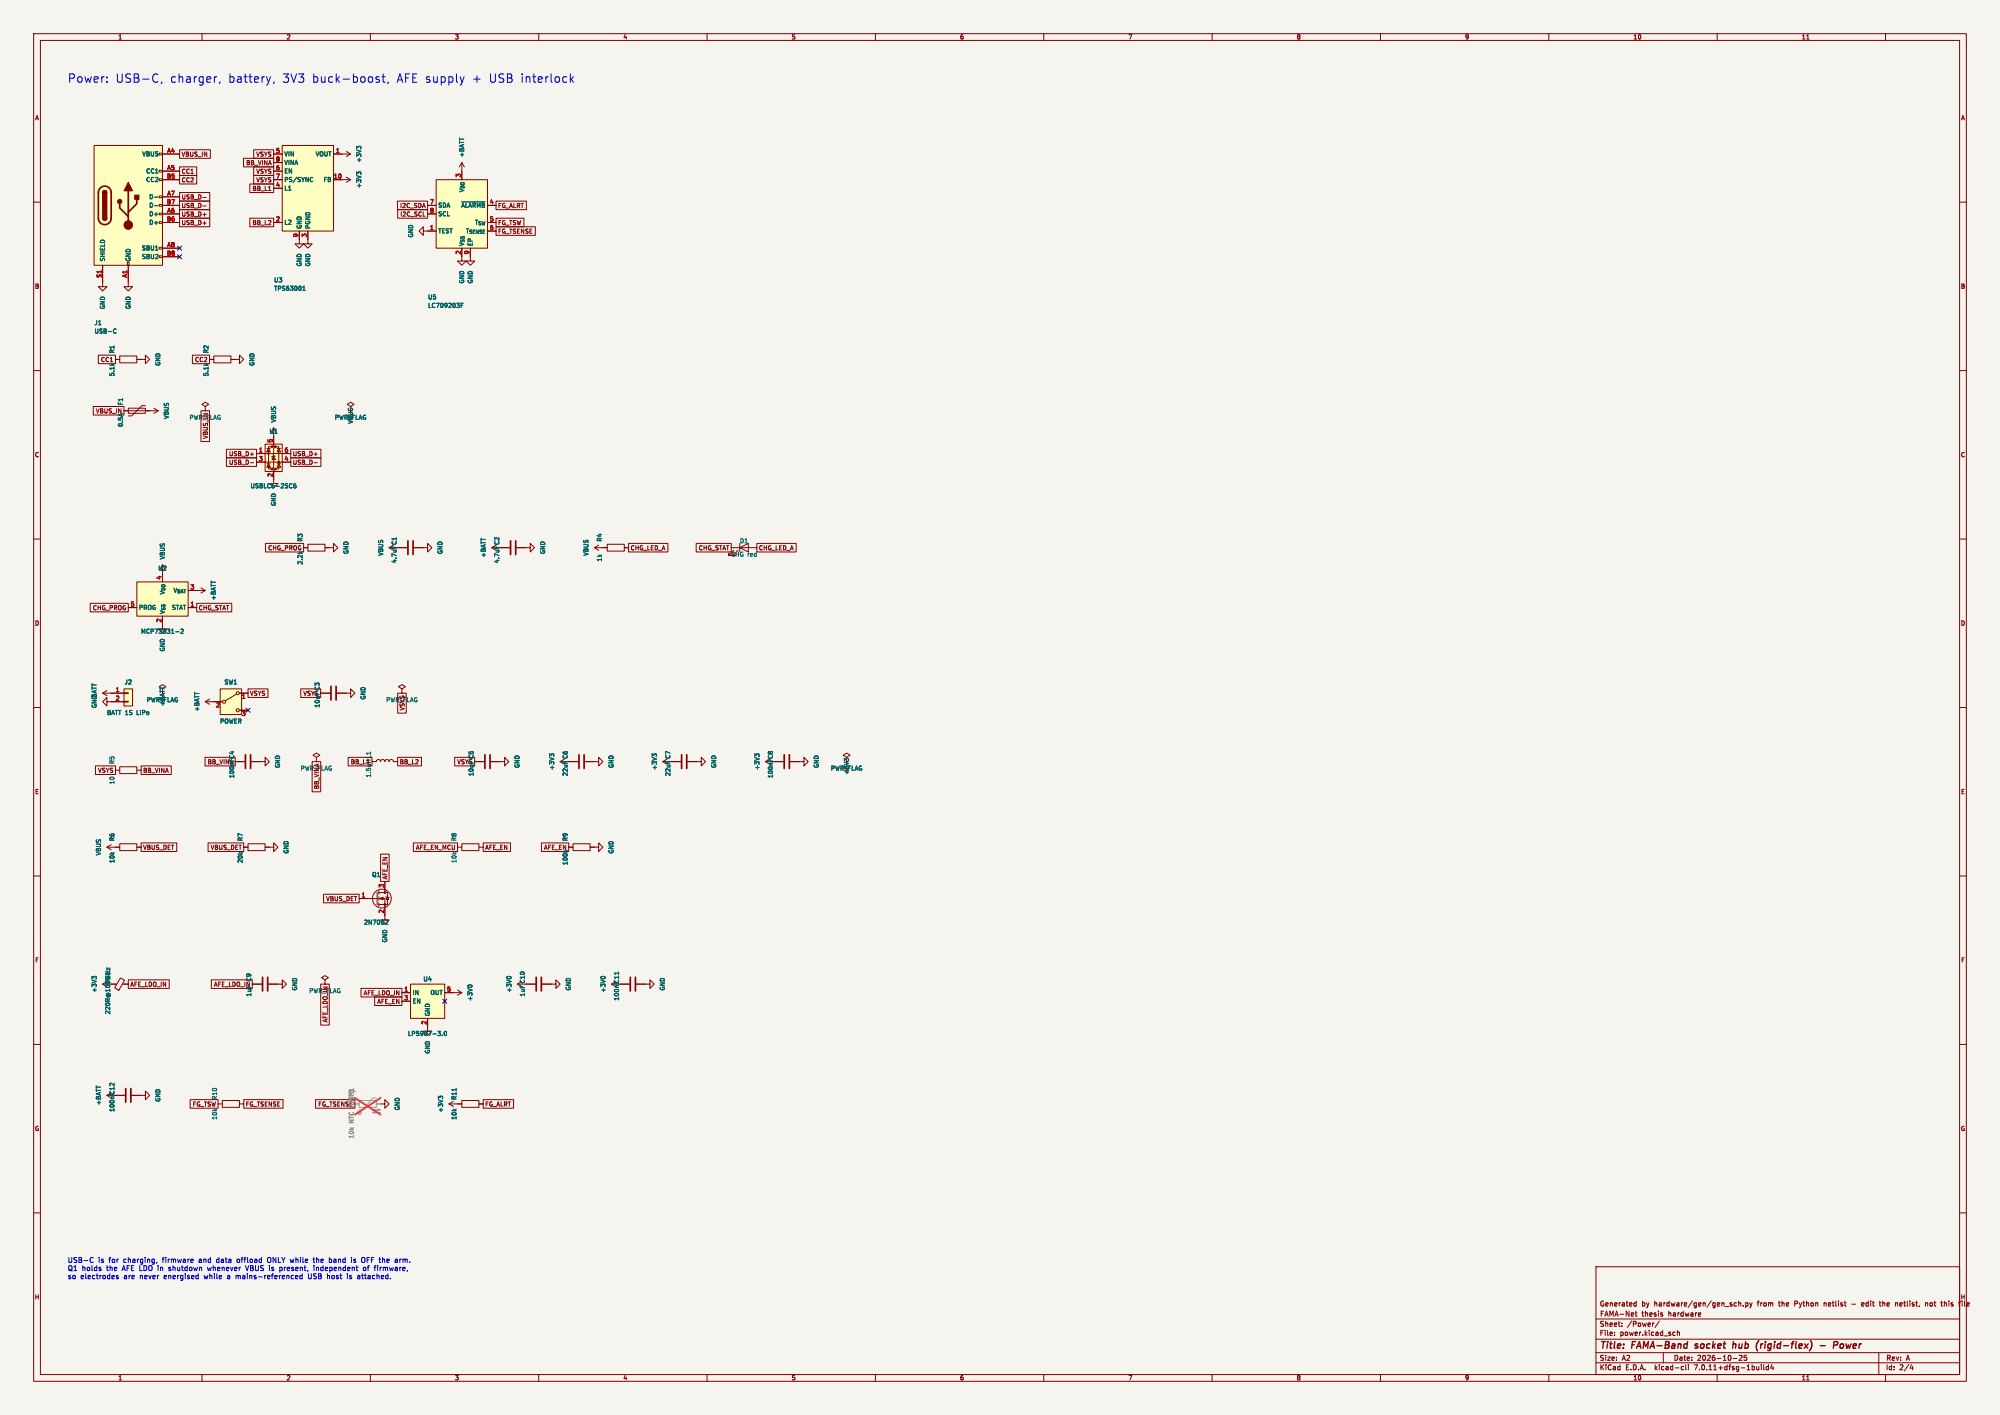
[picture p42: page 2]

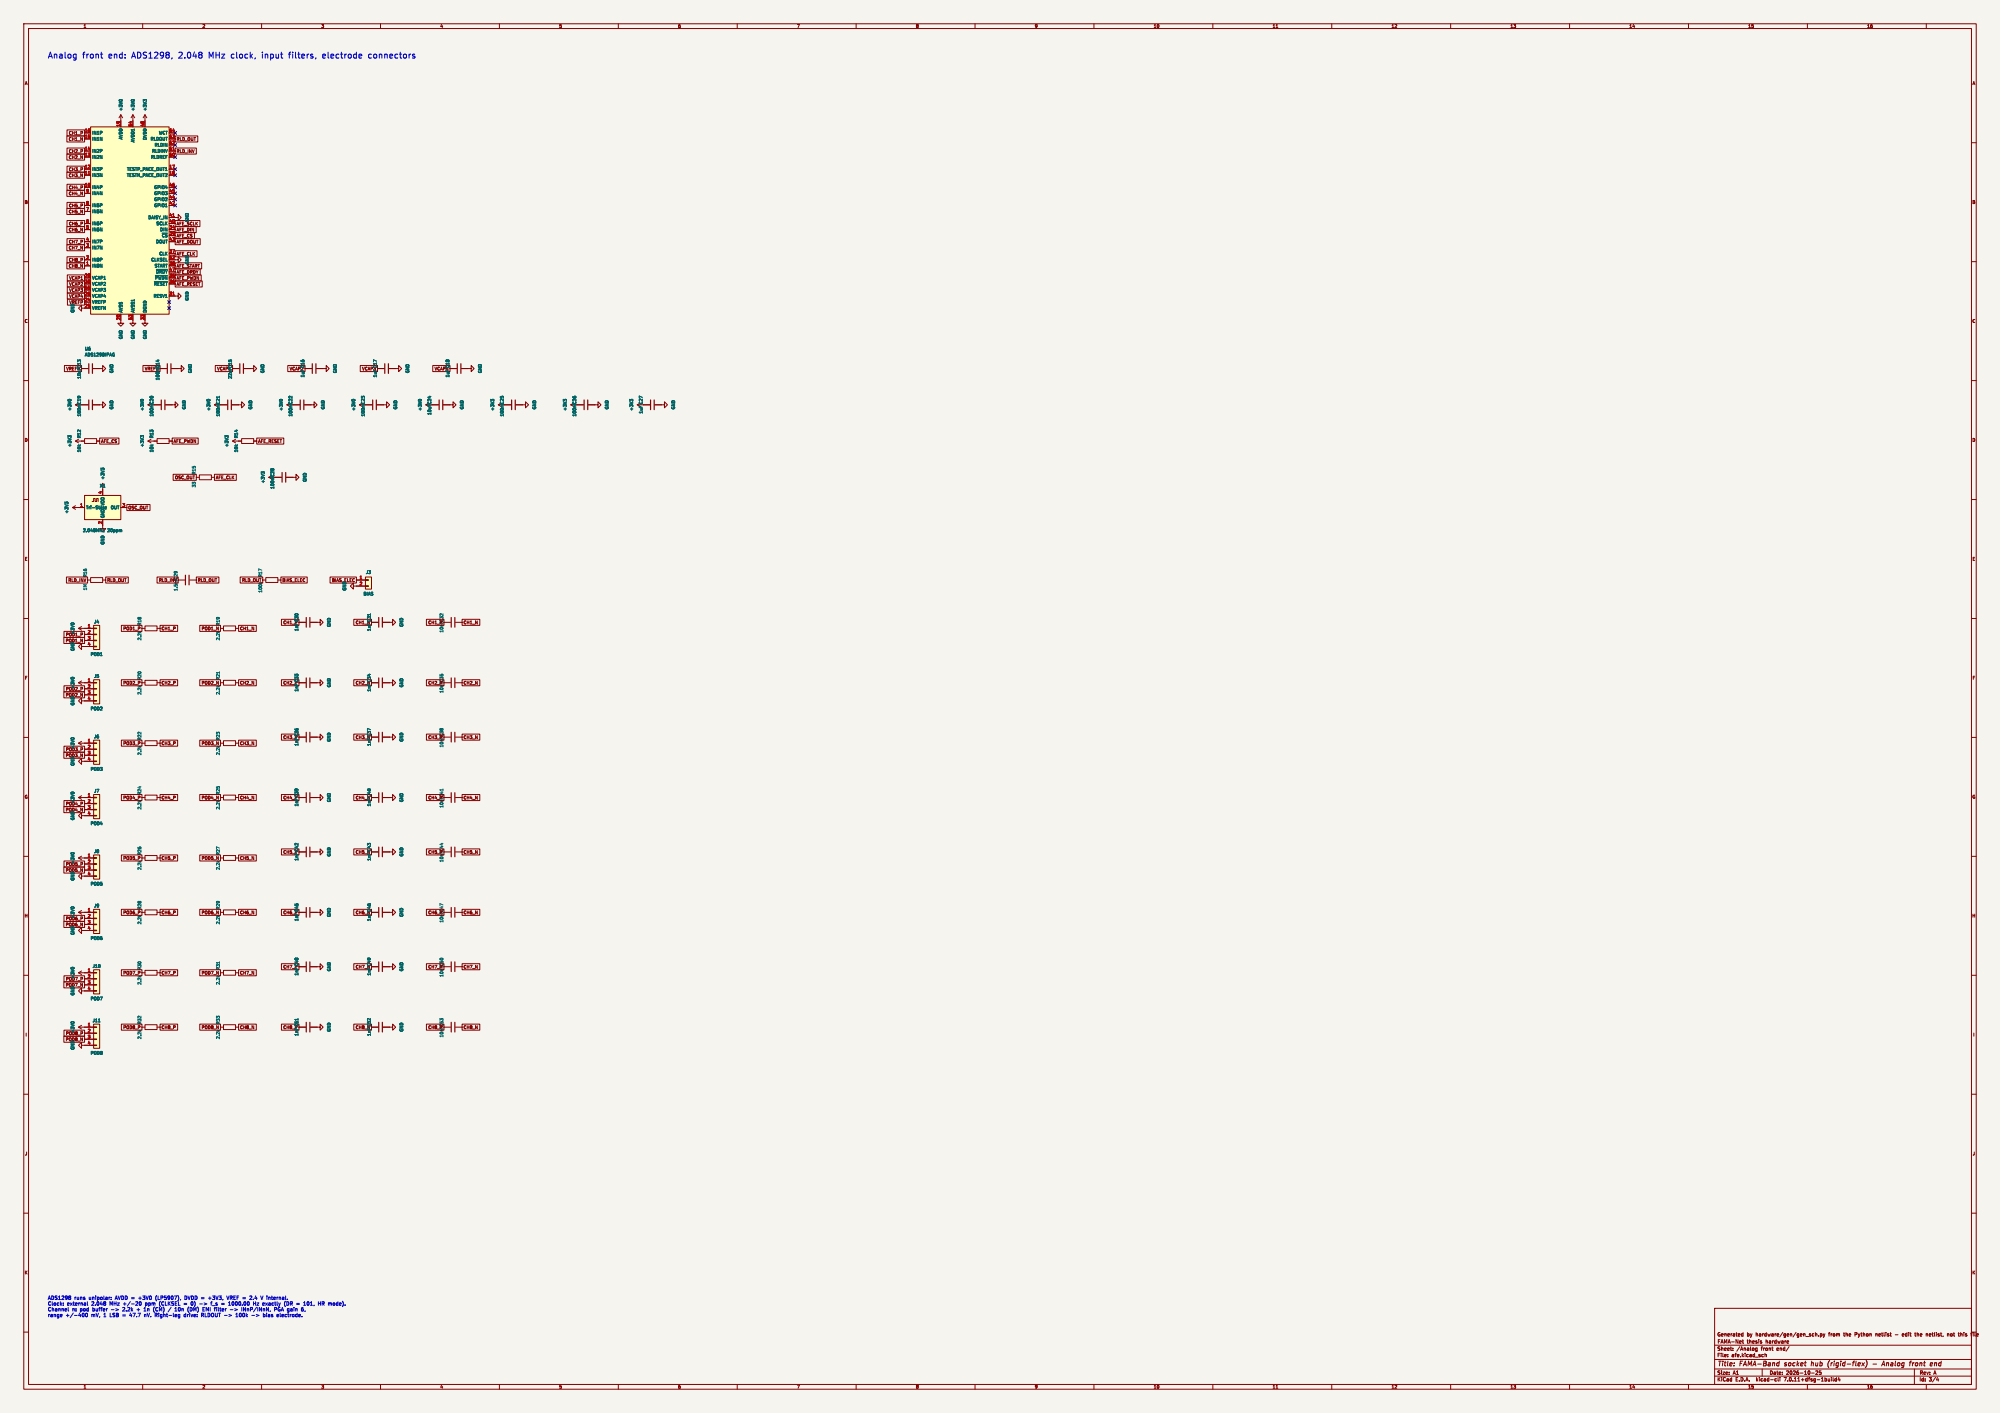
[picture p43: page 3]

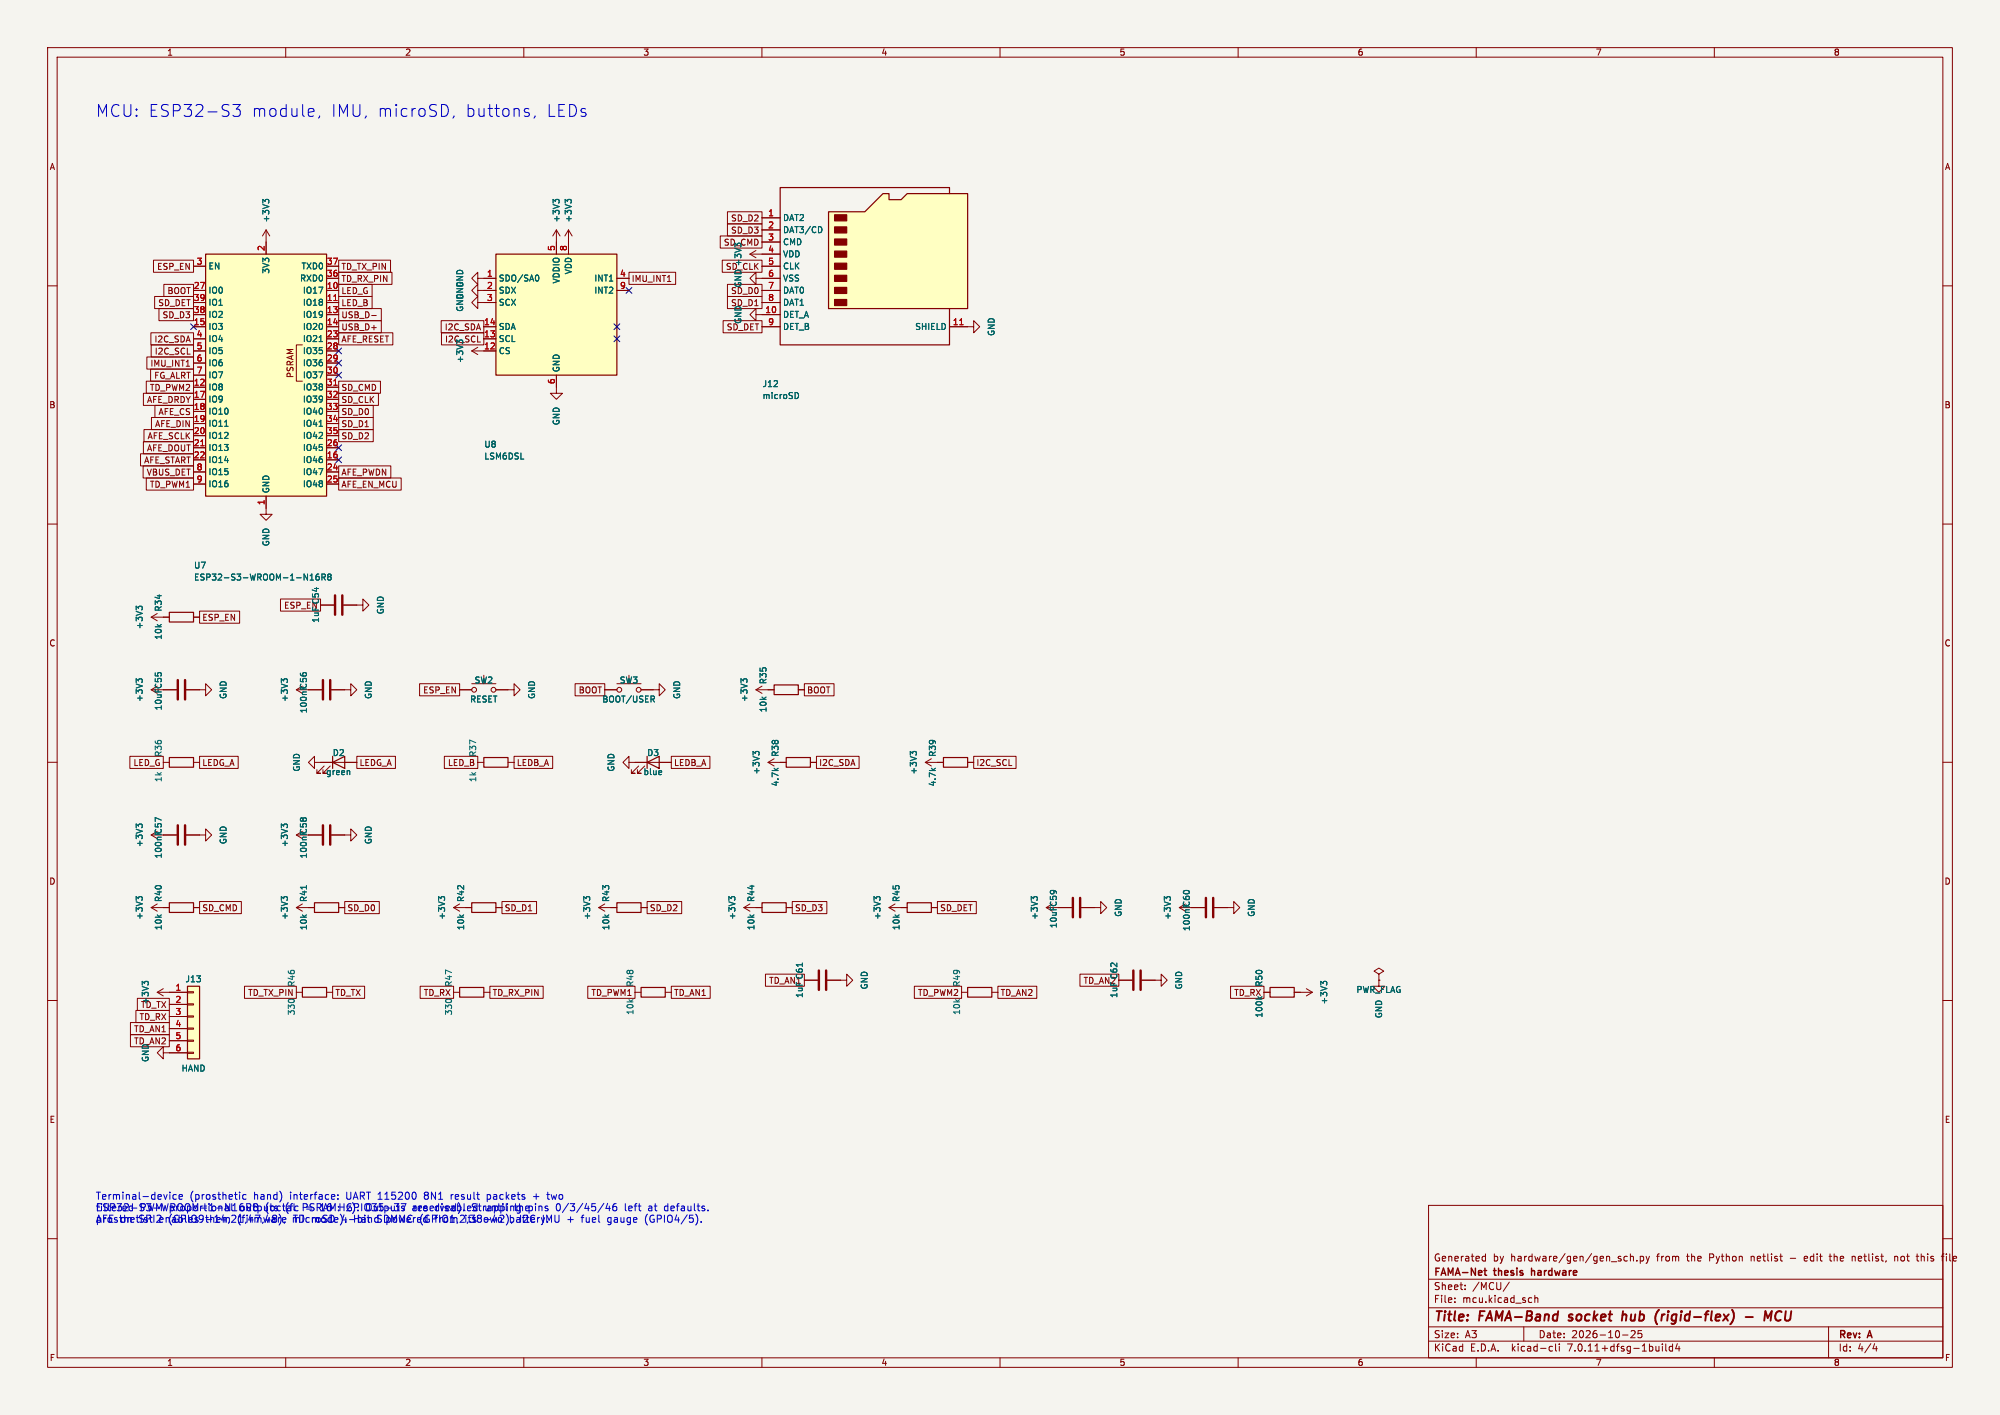
[picture p44: page 4]
