raulkovcs-ux/emg_iot_device/hardware/docs/pod_schematic.pdf

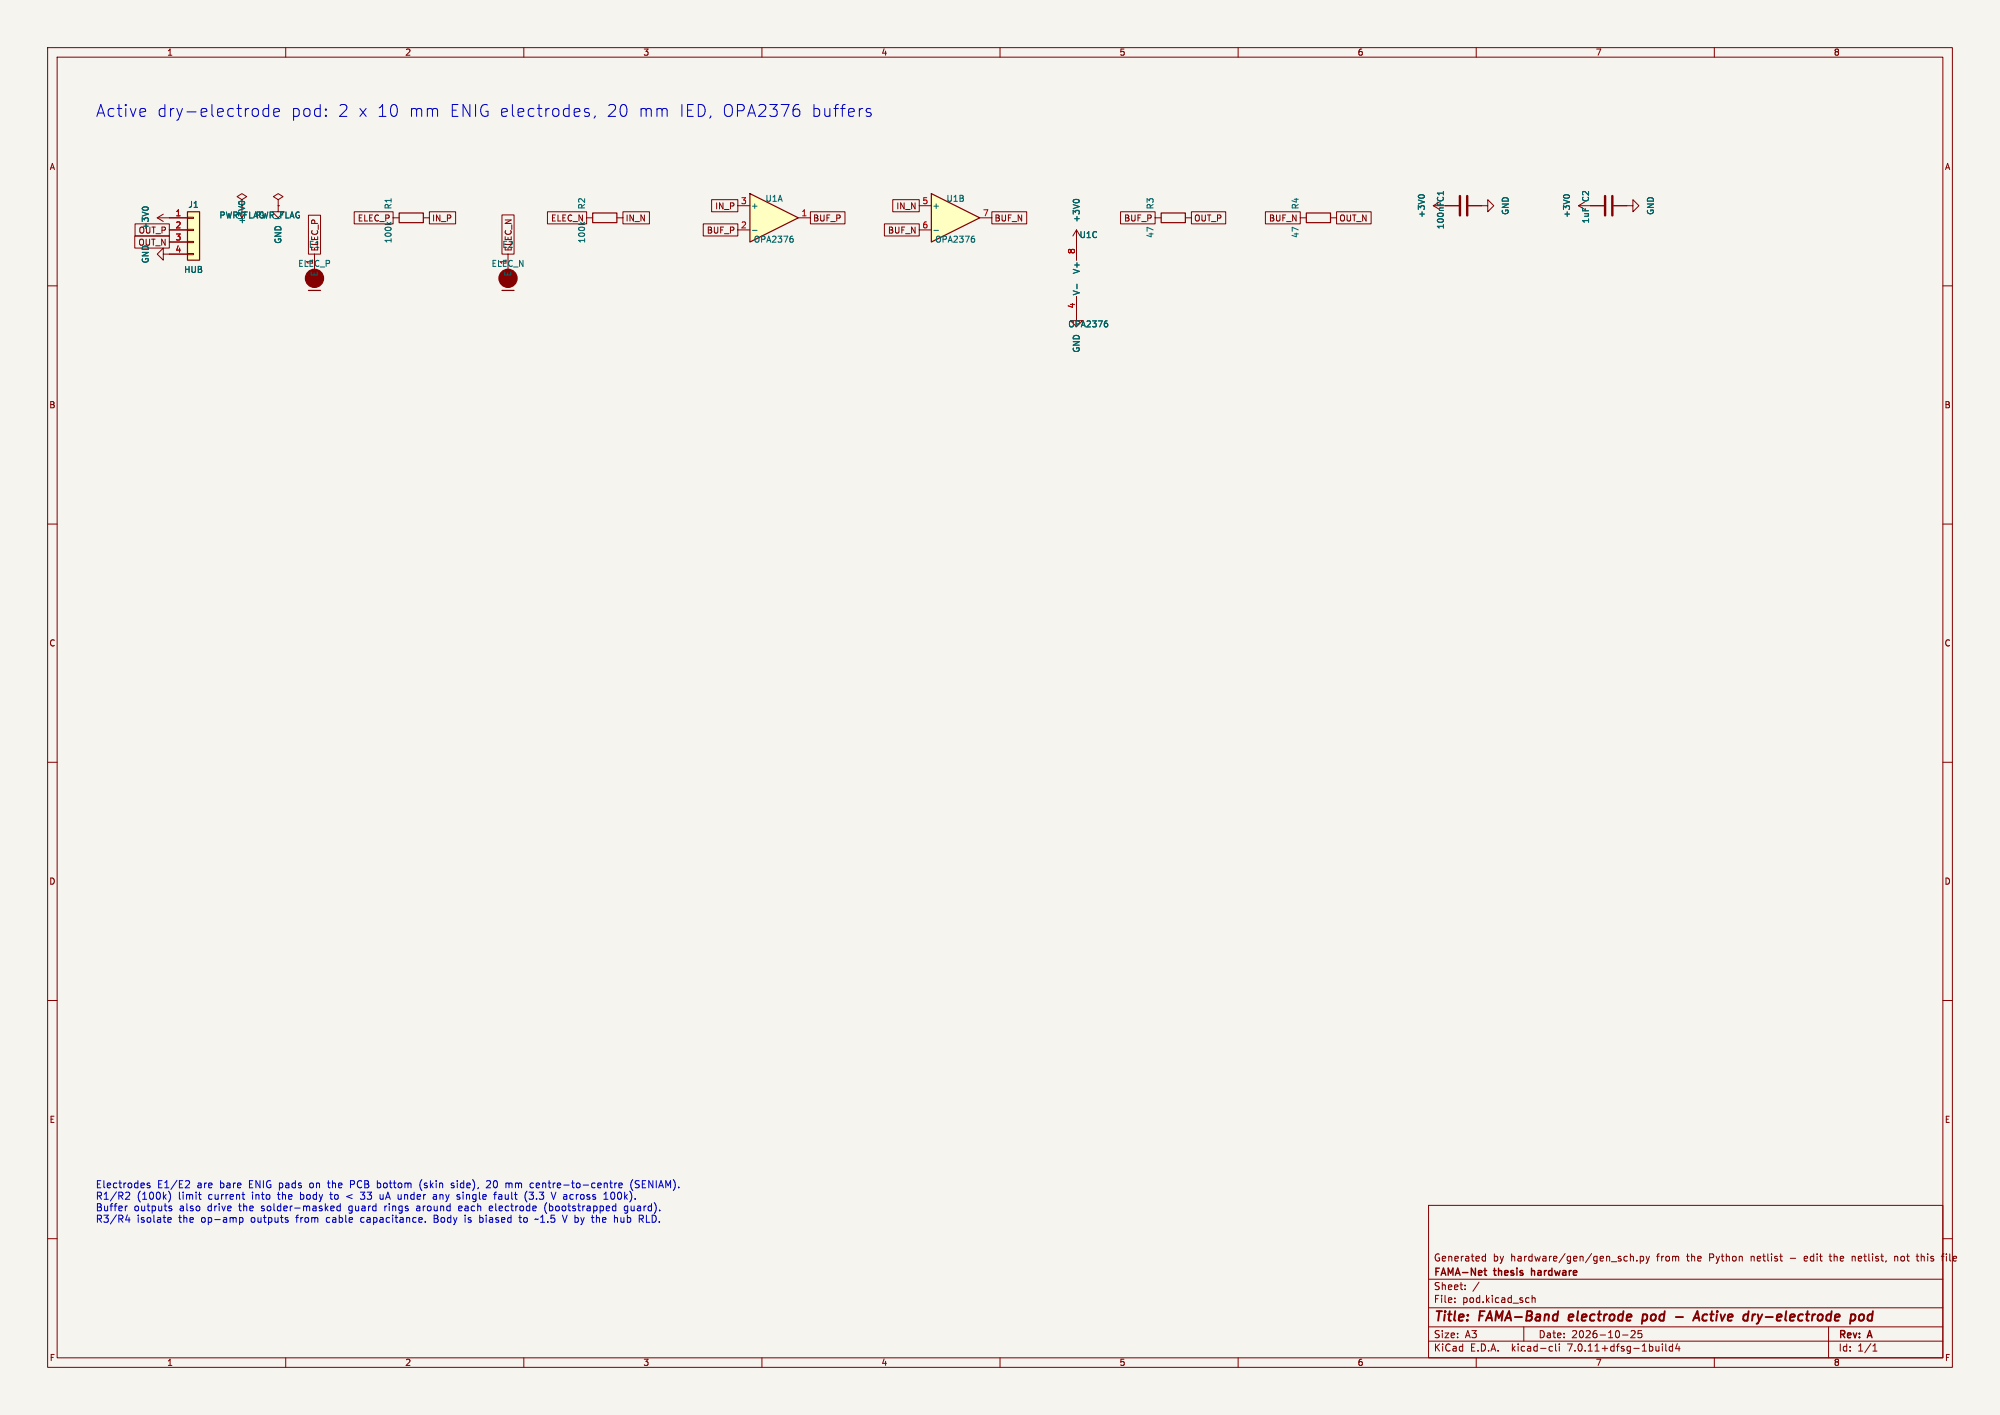
[picture p45: page 1]
