raulkovcs-ux/emg_iot_device/hardware/kicad/hub_flex/hub_flex.kicad_pcb

## KiCad design hardware/kicad/hub_flex/hub_flex.kicad_pcb (2026-10-25)

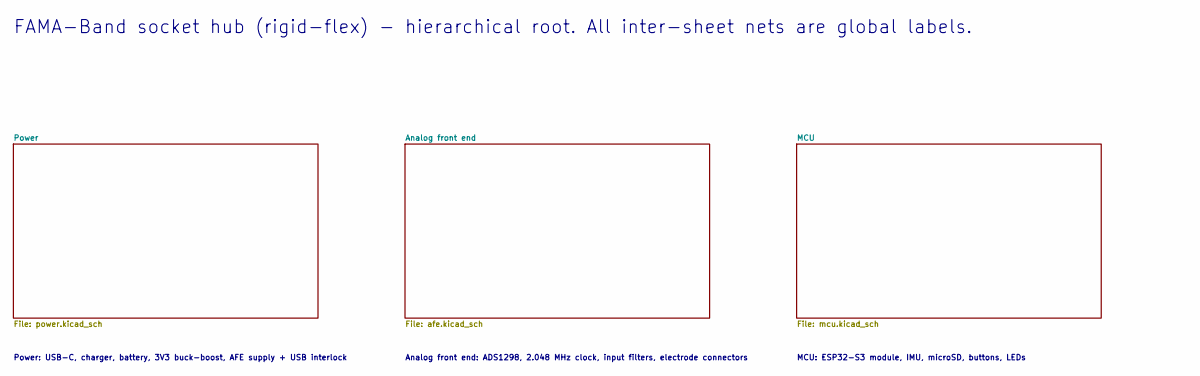
[picture p46: schematic hub_flex.kicad_sch, FAMA-Band socket hub (rigid-flex) - Power]

Notes on the sheet:
Power: USB-C, charger, battery, 3V3 buck-boost, AFE supply + USB interlock
Analog front end: ADS1298, 2.048 MHz clock, input filters, electrode connectors
MCU: ESP32-S3 module, IMU, microSD, buttons, LEDs
FAMA-Band socket hub (rigid-flex) - hierarchical root. All inter-sheet nets are global labels.

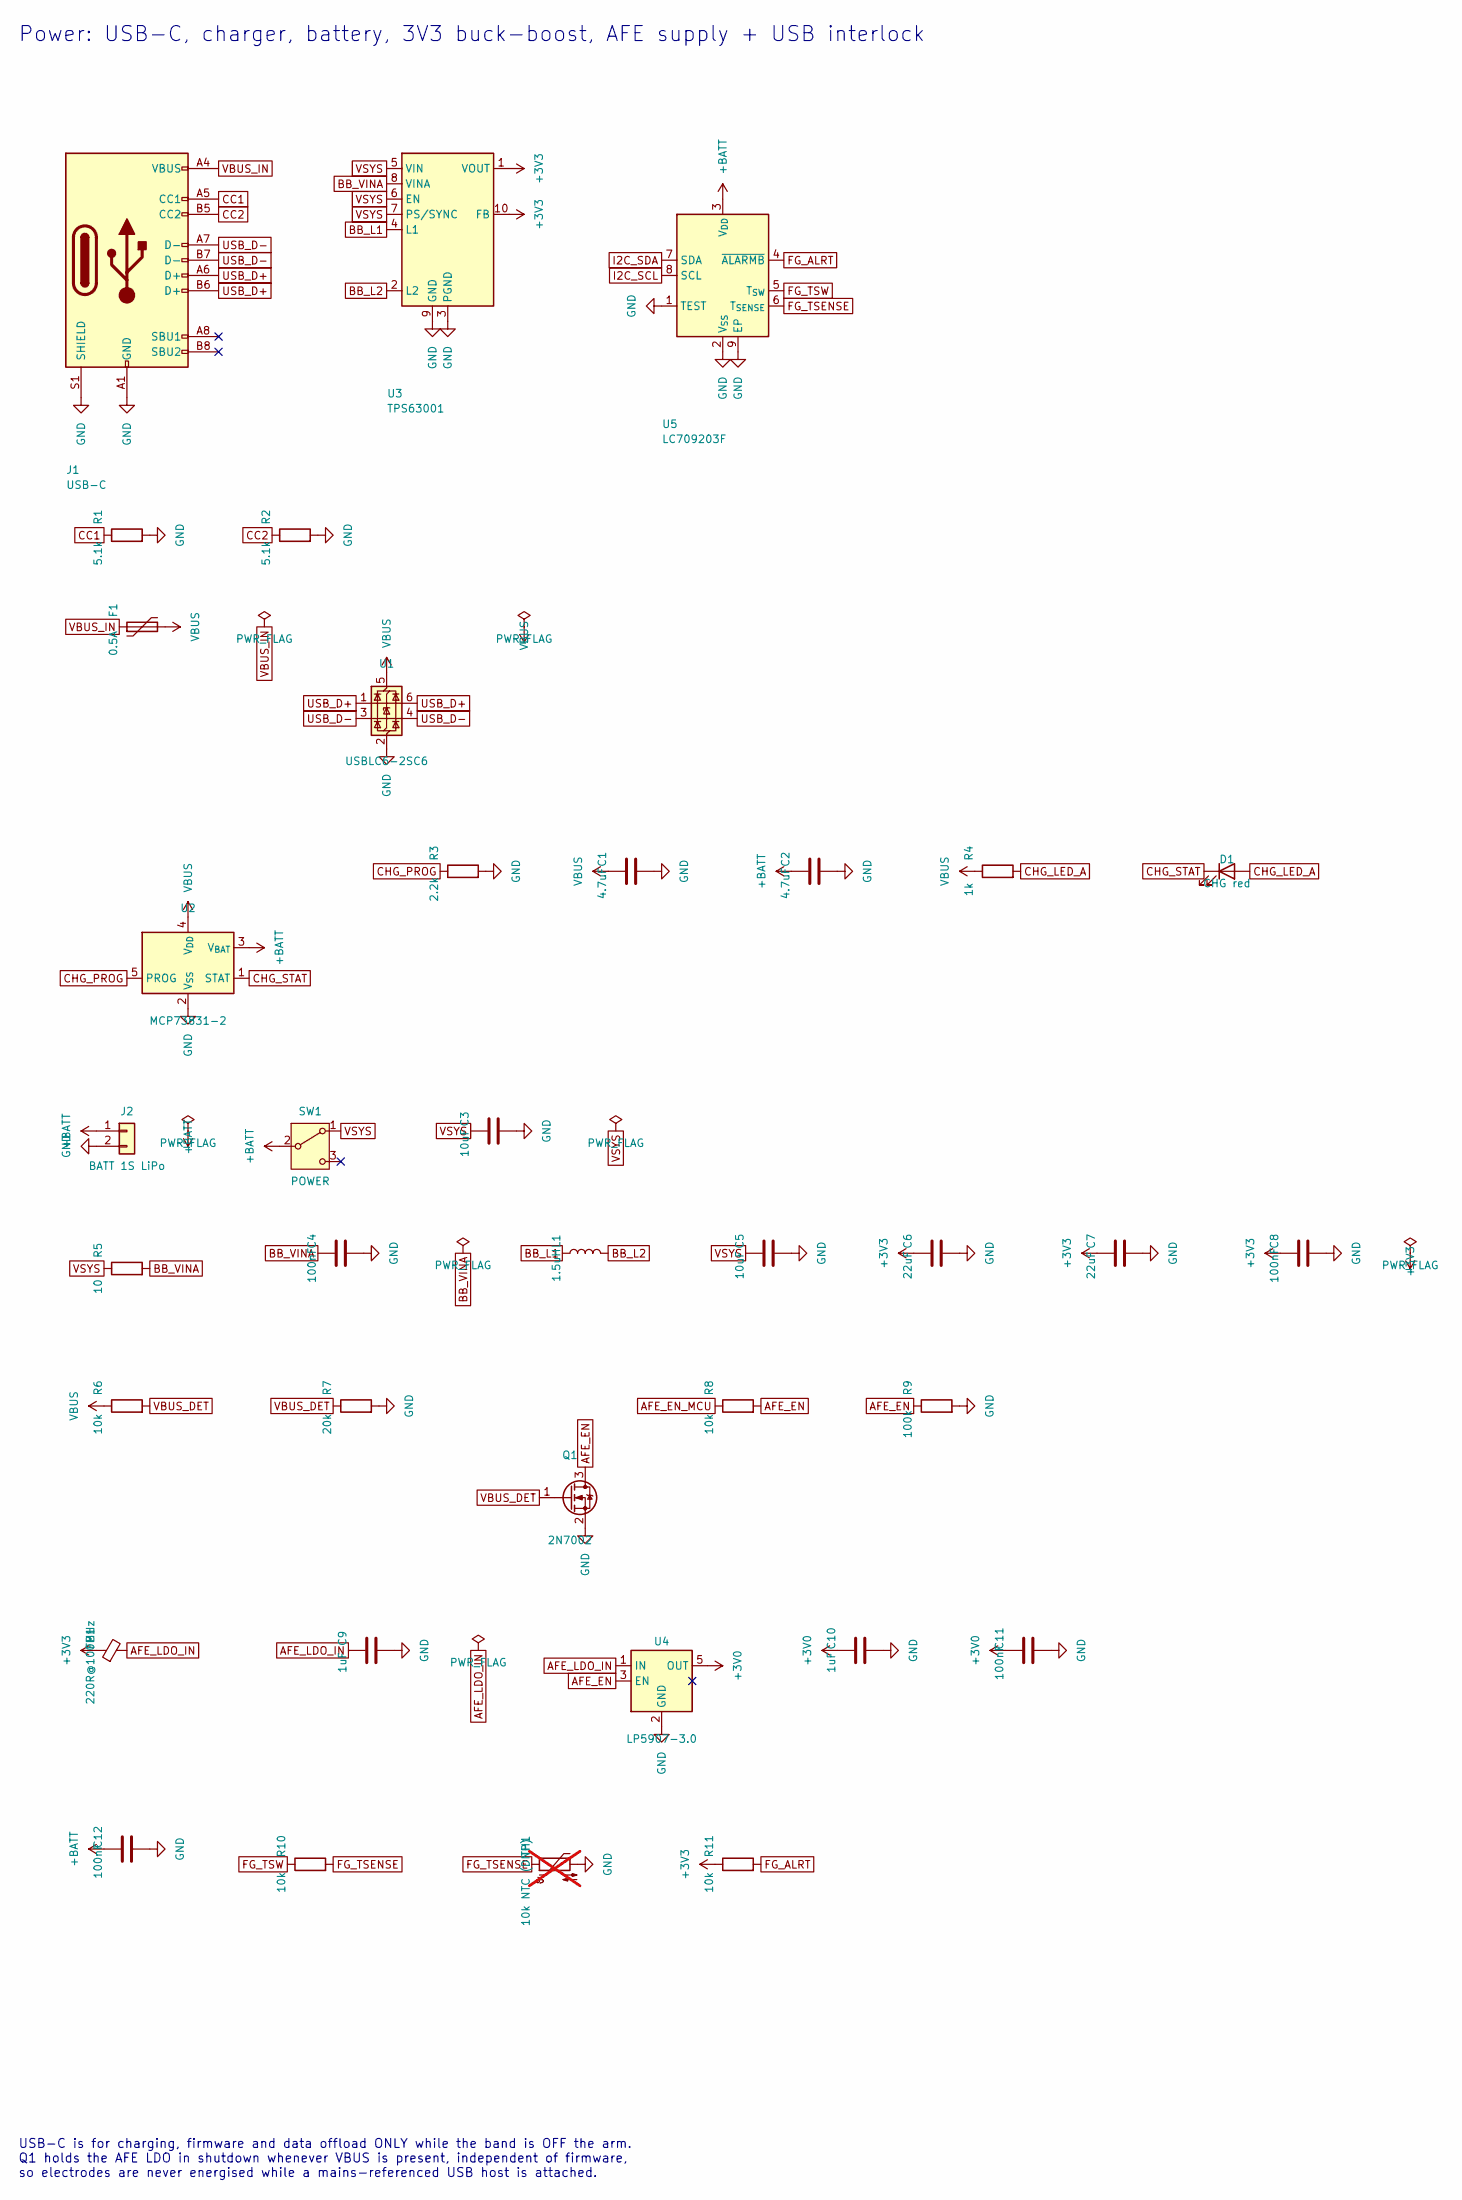
[picture p47: schematic power.kicad_sch, FAMA-Band socket hub (rigid-flex) - Power]

Parts:
C1, C2: 4.7uF; C_0603_1608Metric
C3, C5: 10uF; C_0805_2012Metric
C4, C8, C11, C12: 100nF; C_0402_1005Metric
C6, C7: 22uF; C_0805_2012Metric
C9, C10: 1uF; C_0402_1005Metric
D1: CHG red; LED_0603_1608Metric; MPN 150060RS75000
F1: 0.5A; Fuse_0805_2012Metric
FB1: 220R@100MHz; L_0603_1608Metric; MPN BLM18PG221SN1D
J1: USB-C; USB_C_Receptacle_HRO_TYPE-C-31-M-12; MPN TYPE-C-31-M-12
J2: BATT 1S LiPo; JST_PH_S2B-PH-SM4-TB_1x02-1MP_P2.00mm_Horizontal; MPN S2B-PH-SM4-TB(LF)(SN)
L1: 1.5uH; L_Coilcraft_XxL4020; MPN XFL4020-152MEC
Q1: 2N7002; SOT-23; MPN 2N7002
R1, R2: 5.1k; R_0402_1005Metric
R3: 2.2k; R_0402_1005Metric
R4: 1k; R_0402_1005Metric
R5: 10; R_0402_1005Metric
R6, R8, R10, R11: 10k; R_0402_1005Metric
R7: 20k; R_0402_1005Metric
R9: 100k; R_0402_1005Metric
SW1: POWER; SW_SPDT_PCM12; MPN PCM12SMTR
TH1: 10k NTC (DNP); R_0402_1005Metric; MPN NCP15XH103F03RC; not fitted
U1: USBLC6-2SC6; SOT-23-6; MPN USBLC6-2SC6
U2: MCP73831-2; SOT-23-5; MPN MCP73831T-2ACI/OT
U3: TPS63001; Texas_DRC0010J_ThermalVias; MPN TPS63001DRCR
U4: LP5907-3.0; SOT-23-5; MPN LP5907MFX-3.0/NOPB
U5: LC709203F; WDFN-8-1EP_4x3mm_P0.65mm_EP2.4x1.8mm; MPN LC709203FQH-01TWG

Connections:
+3V0: C10.1, C11.1, U4.5 (OUT); also elsewhere on the board
+3V3: C6.1, C7.1, C8.1, FB1.1, R11.1, U3.1 (VOUT), U3.10 (FB); also elsewhere on the board
+BATT: C2.1, C12.1, J2.1, SW1.2 (B), U2.3 (V_{BAT}), U5.3 (V_{DD})
AFE_EN: Q1.3 (D), R8.2, R9.1, U4.3 (EN)
AFE_EN_MCU: R8.1; also elsewhere on the board
AFE_LDO_IN: C9.1, FB1.2, U4.1 (IN)
BB_L1: L1.1, U3.4 (L1)
BB_L2: L1.2, U3.2 (L2)
BB_VINA: C4.1, R5.2, U3.8 (VINA)
CC1: J1.A5 (CC1), R1.1
CC2: J1.B5 (CC2), R2.1
CHG_LED_A: D1.2 (A), R4.2
CHG_PROG: R3.1, U2.5 (PROG)
CHG_STAT: D1.1 (K), U2.1 (STAT)
FG_ALRT: R11.2, U5.4 (~ALARMB); also elsewhere on the board
FG_TSENSE: R10.2, TH1.1, U5.6 (T_{SENSE})
FG_TSW: R10.1, U5.5 (T_{SW})
GND: C1.2, C2.2, C3.2, C4.2, C5.2, C6.2, C7.2, C8.2, C9.2, C10.2, C11.2, C12.2, J1.A1 (GND), J1.A12 (GND), J1.B1 (GND), J1.B12 (GND), J1.S1 (SHIELD), J2.2, Q1.2 (S), R1.2, R2.2, R3.2, R7.2, R9.2, TH1.2, U1.2 (GND), U2.2 (V_{SS}), U3.3 (PGND), U3.9 (GND), U3.11 (PGND), U4.2 (GND), U5.1 (TEST), U5.2 (V_{SS}), U5.9 (EP); also elsewhere on the board
I2C_SCL: U5.8 (SCL); also elsewhere on the board
I2C_SDA: U5.7 (SDA); also elsewhere on the board
USB_D+: J1.A6 (D+), J1.B6 (D+), U1.1 (I/O1), U1.6 (I/O1); also elsewhere on the board
USB_D-: J1.A7 (D-), J1.B7 (D-), U1.3 (I/O2), U1.4 (I/O2); also elsewhere on the board
VBUS: C1.1, F1.2, R4.1, R6.1, U1.5 (VBUS), U2.4 (V_{DD})
VBUS_DET: Q1.1 (G), R6.2, R7.1; also elsewhere on the board
VBUS_IN: F1.1, J1.A4 (VBUS), J1.A9 (VBUS), J1.B4 (VBUS), J1.B9 (VBUS)
VSYS: C3.1, C5.1, R5.1, SW1.1 (A), U3.5 (VIN), U3.6 (EN), U3.7 (PS/SYNC)

Notes on the sheet:
Power: USB-C, charger, battery, 3V3 buck-boost, AFE supply + USB interlock
USB-C is for charging, firmware and data offload ONLY while the band is OFF the arm. Q1 holds the AFE LDO in shutdown whenever VBUS is present, independent of firmware, so electrodes are never energised while a mains-referenced USB host is attached.

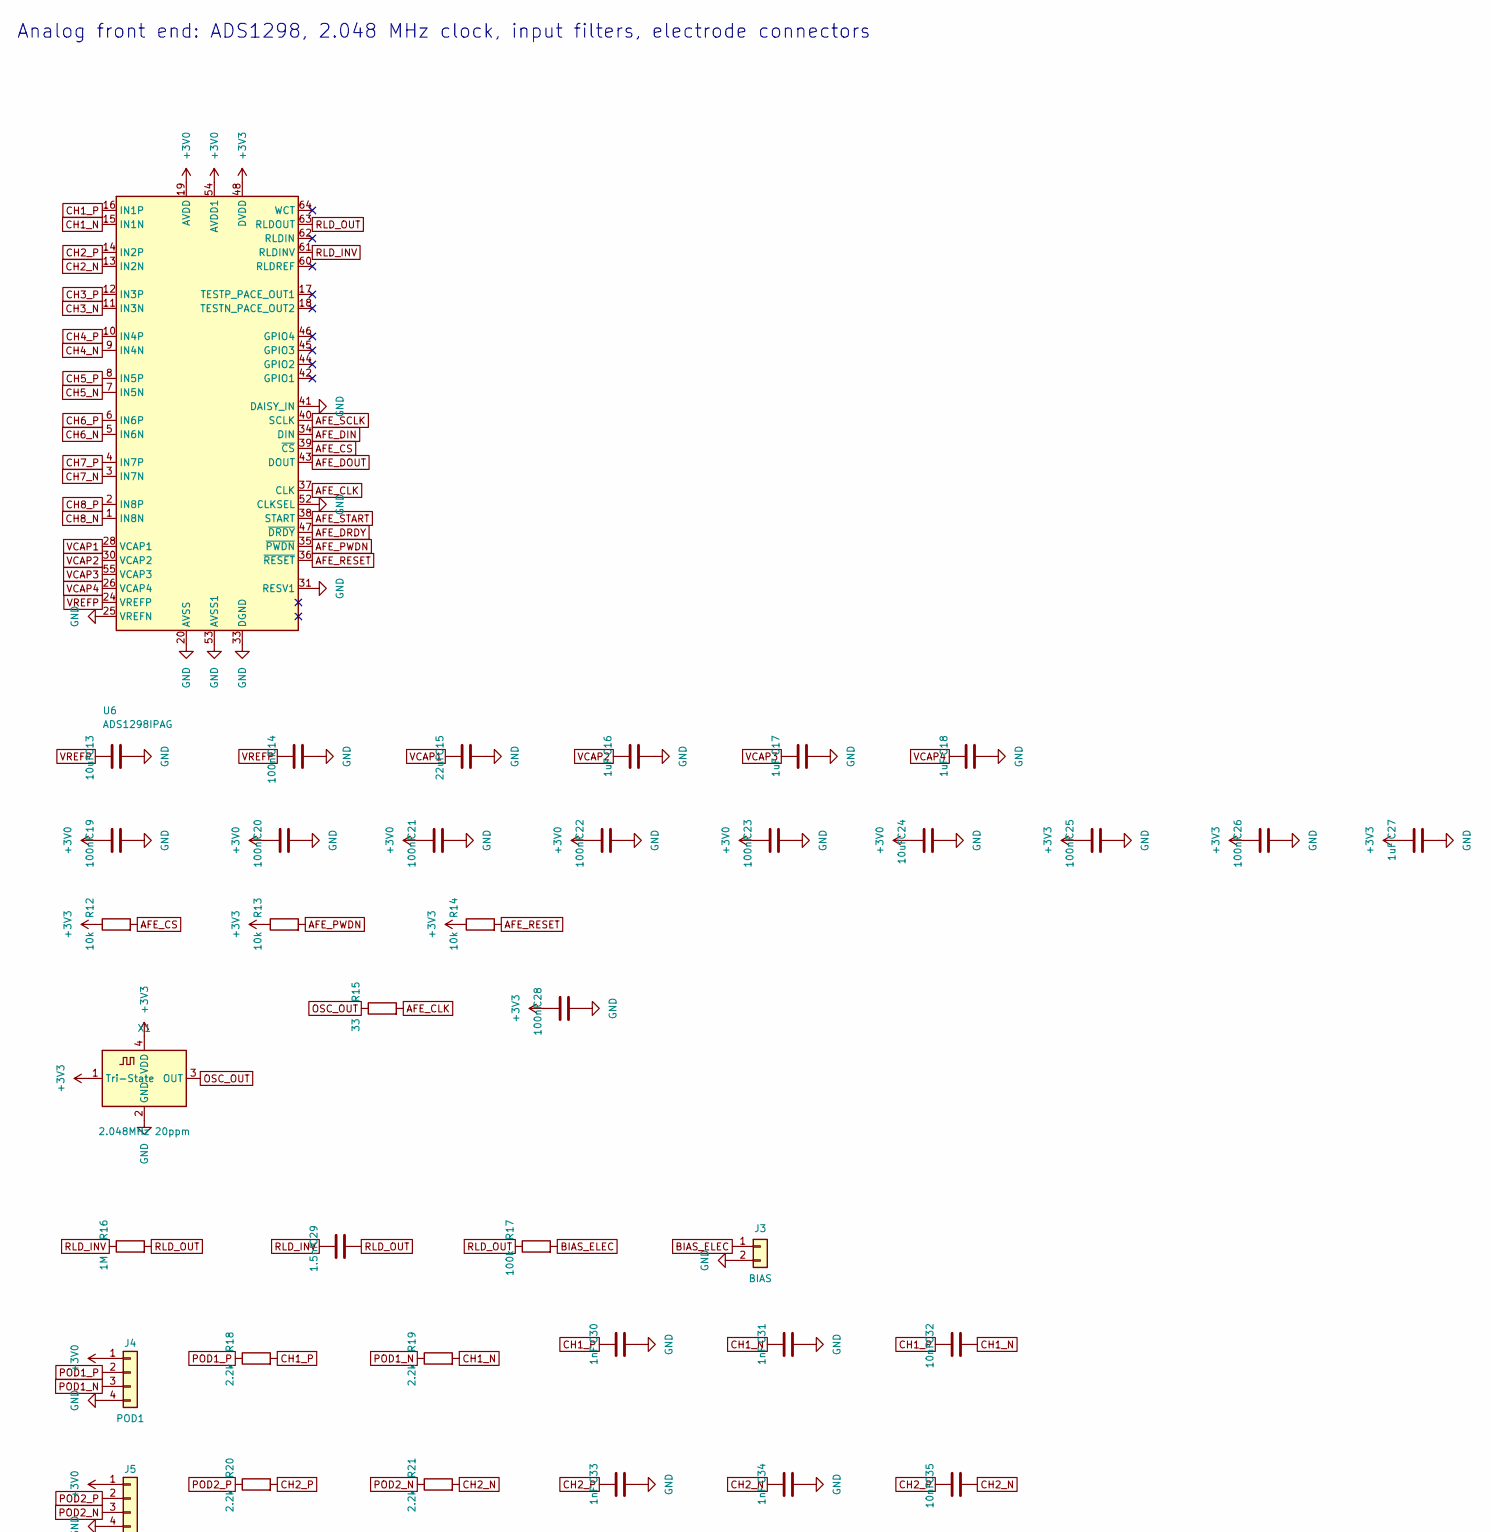
[picture p48: schematic afe.kicad_sch, FAMA-Band socket hub (rigid-flex) - Analog front end, part in row 1, column 1]

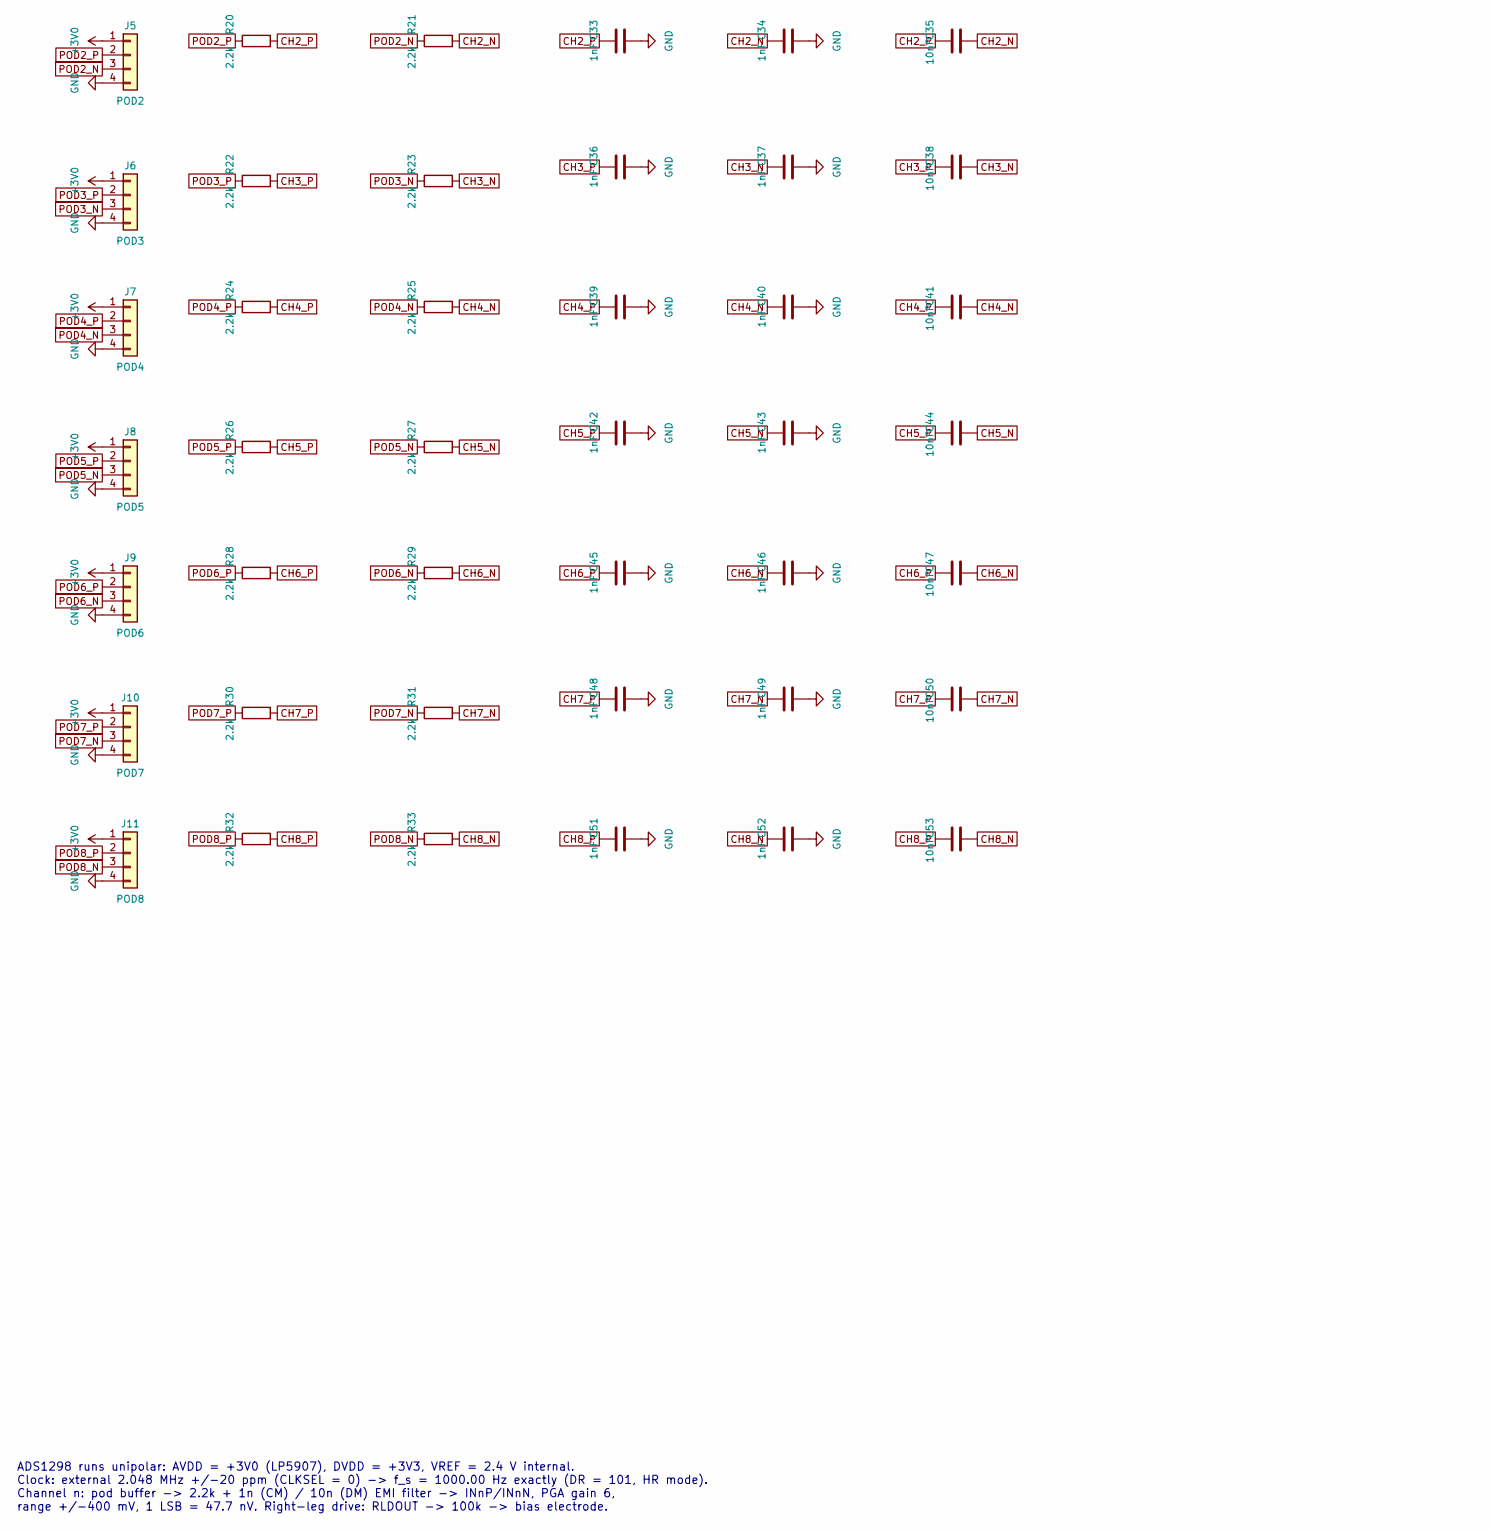
[picture p49: schematic afe.kicad_sch, FAMA-Band socket hub (rigid-flex) - Analog front end, part in row 2, column 1]

Parts:
C13, C24: 10uF; C_0603_1608Metric
C14, C19, C20, C21, C22, C23, C25, C26, C28: 100nF; C_0402_1005Metric
C15: 22uF; C_0805_2012Metric
C16, C17, C18, C27: 1uF; C_0402_1005Metric
C29: 1.5nF; C_0402_1005Metric
C30, C31, C33, C34, C36, C37, C39, C40, C42, C43, C45, C46, C48, C49, C51, C52: 1nF; C_0402_1005Metric
C32, C35, C38, C41, C44, C47, C50, C53: 10nF; C_0402_1005Metric
J3: BIAS; JST_GH_SM02B-GHS-TB_1x02-1MP_P1.25mm_Horizontal; MPN SM02B-GHS-TB(LF)(SN)
J4: POD1; JST_GH_SM04B-GHS-TB_1x04-1MP_P1.25mm_Horizontal; MPN SM04B-GHS-TB(LF)(SN)
J5: POD2; JST_GH_SM04B-GHS-TB_1x04-1MP_P1.25mm_Horizontal; MPN SM04B-GHS-TB(LF)(SN)
J6: POD3; JST_GH_SM04B-GHS-TB_1x04-1MP_P1.25mm_Horizontal; MPN SM04B-GHS-TB(LF)(SN)
J7: POD4; JST_GH_SM04B-GHS-TB_1x04-1MP_P1.25mm_Horizontal; MPN SM04B-GHS-TB(LF)(SN)
J8: POD5; JST_GH_SM04B-GHS-TB_1x04-1MP_P1.25mm_Horizontal; MPN SM04B-GHS-TB(LF)(SN)
J9: POD6; JST_GH_SM04B-GHS-TB_1x04-1MP_P1.25mm_Horizontal; MPN SM04B-GHS-TB(LF)(SN)
J10: POD7; JST_GH_SM04B-GHS-TB_1x04-1MP_P1.25mm_Horizontal; MPN SM04B-GHS-TB(LF)(SN)
J11: POD8; JST_GH_SM04B-GHS-TB_1x04-1MP_P1.25mm_Horizontal; MPN SM04B-GHS-TB(LF)(SN)
R12, R13, R14: 10k; R_0402_1005Metric
R15: 33; R_0402_1005Metric
R16: 1M; R_0402_1005Metric
R17: 100k; R_0603_1608Metric
R18, R19, R20, R21, R22, R23, R24, R25, R26, R27, R28, R29, R30, R31, R32, R33: 2.2k; R_0402_1005Metric
U6: ADS1298IPAG; TQFP-64_10x10mm_P0.5mm; MPN ADS1298IPAG
X1: 2.048MHz 20ppm; Oscillator_SMD_ECS_2520MV-xxx-xx-4Pin_2.5x2.0mm; MPN SiT8008BI-xx-33E-2.048000

Connections:
+3V0: C19.1, C20.1, C21.1, C22.1, C23.1, C24.1, J4.1, J5.1, J6.1, J7.1, J8.1, J9.1, J10.1, J11.1, U6.19 (AVDD), U6.21 (AVDD), U6.22 (AVDD), U6.54 (AVDD1), U6.56 (AVDD), U6.59 (AVDD); also elsewhere on the board
+3V3: C25.1, C26.1, C27.1, C28.1, R12.1, R13.1, R14.1, U6.48 (DVDD), U6.50 (DVDD), X1.1 (Tri-State), X1.4 (VDD); also elsewhere on the board
AFE_CLK: R15.2, U6.37 (CLK)
AFE_CS: R12.2, U6.39 (~CS); also elsewhere on the board
AFE_DIN: U6.34 (DIN); also elsewhere on the board
AFE_DOUT: U6.43 (DOUT); also elsewhere on the board
AFE_DRDY: U6.47 (~DRDY); also elsewhere on the board
AFE_PWDN: R13.2, U6.35 (~PWDN); also elsewhere on the board
AFE_RESET: R14.2, U6.36 (~RESET); also elsewhere on the board
AFE_SCLK: U6.40 (SCLK); also elsewhere on the board
AFE_START: U6.38 (START); also elsewhere on the board
BIAS_ELEC: J3.1, R17.2
CH1_N: C31.1, C32.2, R19.2, U6.15 (IN1N)
CH1_P: C30.1, C32.1, R18.2, U6.16 (IN1P)
CH2_N: C34.1, C35.2, R21.2, U6.13 (IN2N)
CH2_P: C33.1, C35.1, R20.2, U6.14 (IN2P)
CH3_N: C37.1, C38.2, R23.2, U6.11 (IN3N)
CH3_P: C36.1, C38.1, R22.2, U6.12 (IN3P)
CH4_N: C40.1, C41.2, R25.2, U6.9 (IN4N)
CH4_P: C39.1, C41.1, R24.2, U6.10 (IN4P)
CH5_N: C43.1, C44.2, R27.2, U6.7 (IN5N)
CH5_P: C42.1, C44.1, R26.2, U6.8 (IN5P)
CH6_N: C46.1, C47.2, R29.2, U6.5 (IN6N)
CH6_P: C45.1, C47.1, R28.2, U6.6 (IN6P)
CH7_N: C49.1, C50.2, R31.2, U6.3 (IN7N)
CH7_P: C48.1, C50.1, R30.2, U6.4 (IN7P)
CH8_N: C52.1, C53.2, R33.2, U6.1 (IN8N)
CH8_P: C51.1, C53.1, R32.2, U6.2 (IN8P)
GND: C13.2, C14.2, C15.2, C16.2, C17.2, C18.2, C19.2, C20.2, C21.2, C22.2, C23.2, C24.2, C25.2, C26.2, C27.2, C28.2, C30.2, C31.2, C33.2, C34.2, C36.2, C37.2, C39.2, C40.2, C42.2, C43.2, C45.2, C46.2, C48.2, C49.2, C51.2, C52.2, J3.2, J4.4, J5.4, J6.4, J7.4, J8.4, J9.4, J10.4, J11.4, U6.20 (AVSS), U6.23 (AVSS), U6.25 (VREFN), U6.31 (RESV1), U6.32 (AVSS), U6.33 (DGND), U6.41 (DAISY_IN), U6.49 (DGND), U6.51 (DGND), U6.52 (CLKSEL), U6.53 (AVSS1), U6.57 (AVSS), U6.58 (AVSS), X1.2 (GND); also elsewhere on the board
OSC_OUT: R15.1, X1.3 (OUT)
POD1_N: J4.3, R19.1
POD1_P: J4.2, R18.1
POD2_N: J5.3, R21.1
POD2_P: J5.2, R20.1
POD3_N: J6.3, R23.1
POD3_P: J6.2, R22.1
POD4_N: J7.3, R25.1
POD4_P: J7.2, R24.1
POD5_N: J8.3, R27.1
POD5_P: J8.2, R26.1
POD6_N: J9.3, R29.1
POD6_P: J9.2, R28.1
POD7_N: J10.3, R31.1
POD7_P: J10.2, R30.1
POD8_N: J11.3, R33.1
POD8_P: J11.2, R32.1
RLD_INV: C29.1, R16.1, U6.61 (RLDINV)
RLD_OUT: C29.2, R16.2, R17.1, U6.63 (RLDOUT)
VCAP1: C15.1, U6.28 (VCAP1)
VCAP2: C16.1, U6.30 (VCAP2)
VCAP3: C17.1, U6.55 (VCAP3)
VCAP4: C18.1, U6.26 (VCAP4)
VREFP: C13.1, C14.1, U6.24 (VREFP)

Notes on the sheet:
Analog front end: ADS1298, 2.048 MHz clock, input filters, electrode connectors
ADS1298 runs unipolar: AVDD = +3V0 (LP5907), DVDD = +3V3, VREF = 2.4 V internal. Clock: external 2.048 MHz +/-20 ppm (CLKSEL = 0) -> f_s = 1000.00 Hz exactly (DR = 101, HR mode). Channel n: pod buffer -> 2.2k + 1n (CM) / 10n (DM) EMI filter -> INnP/INnN, PGA gain 6, range +/-400 mV, 1 LSB = 47.7 nV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

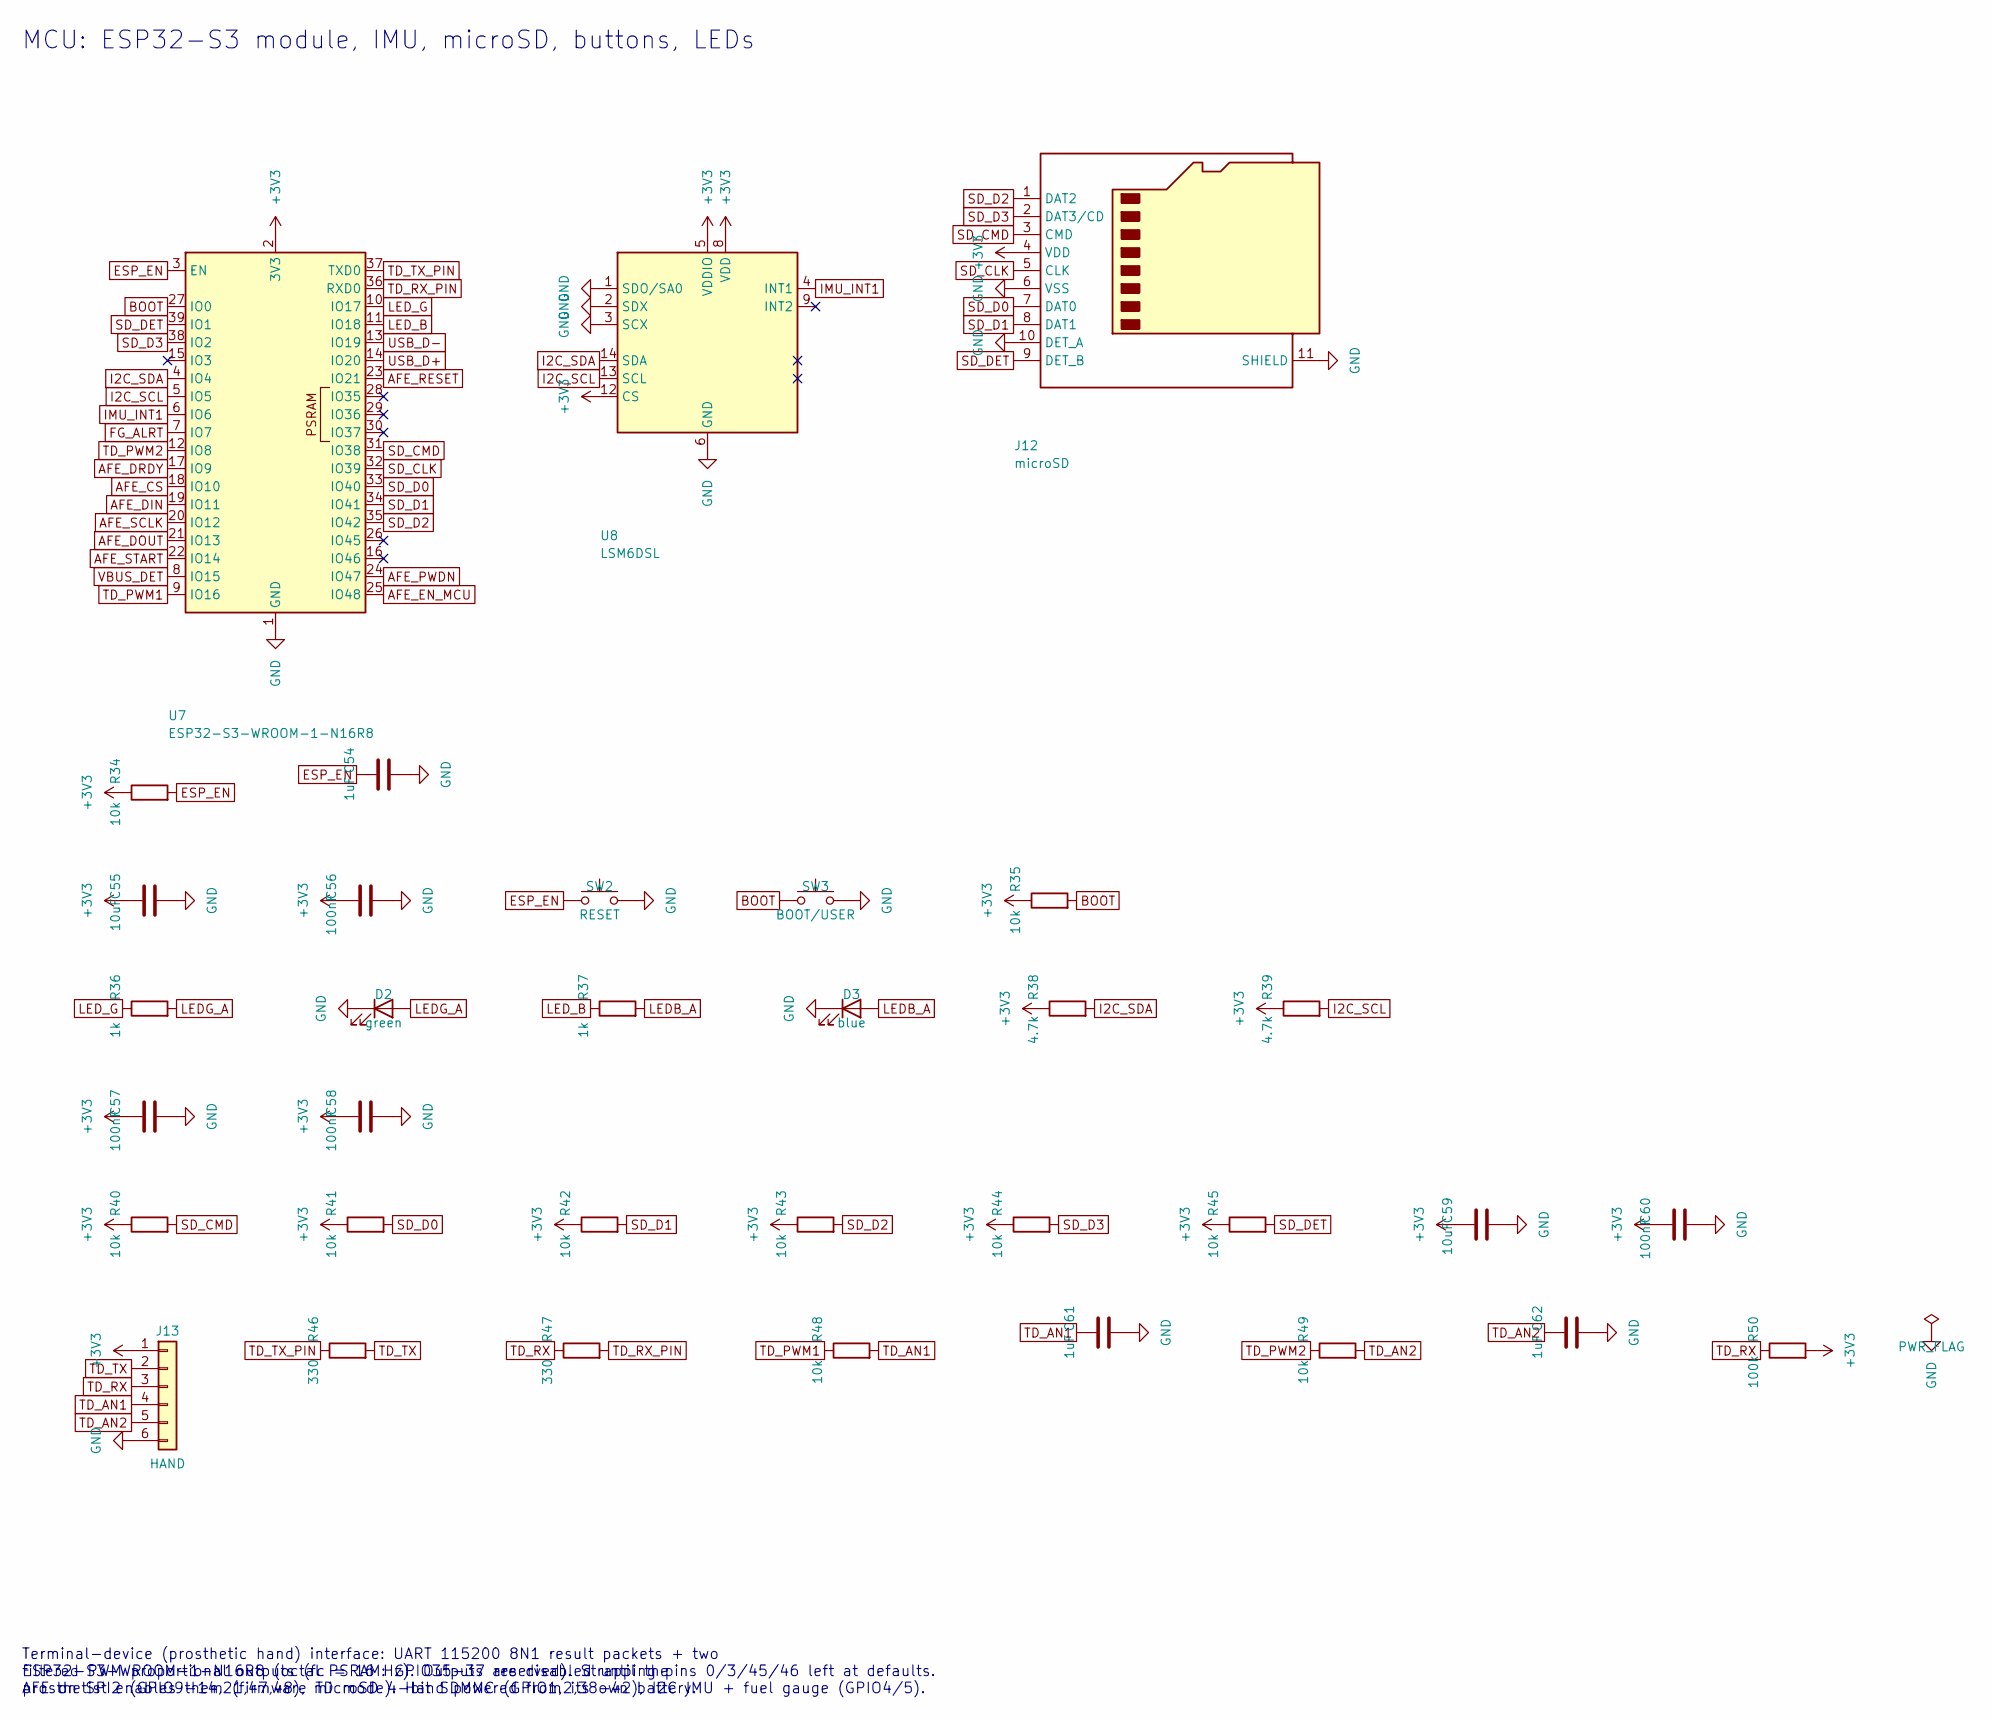
[picture p50: schematic mcu.kicad_sch, FAMA-Band socket hub (rigid-flex) - MCU]

Parts:
C54: 1uF; C_0402_1005Metric
C55, C59: 10uF; C_0603_1608Metric
C56, C57, C58, C60: 100nF; C_0402_1005Metric
C61, C62: 1uF; C_0603_1608Metric
D2: green; LED_0603_1608Metric; MPN 150060GS75000
D3: blue; LED_0603_1608Metric; MPN 150060BS75000
J12: microSD; microSD_HC_Hirose_DM3AT-SF-PEJM5; MPN DM3AT-SF-PEJM5
J13: HAND; JST_GH_SM06B-GHS-TB_1x06-1MP_P1.25mm_Horizontal; MPN SM06B-GHS-TB(LF)(SN)
R34, R35, R40, R41, R42, R43, R44, R45, R48, R49: 10k; R_0402_1005Metric
R36, R37: 1k; R_0402_1005Metric
R38, R39: 4.7k; R_0402_1005Metric
R46, R47: 330; R_0402_1005Metric
R50: 100k; R_0402_1005Metric
SW2: RESET; SW_Push_1P1T_NO_CK_KMR2; MPN KMR221GLFS
SW3: BOOT/USER; SW_Push_1P1T_NO_CK_KMR2; MPN KMR221GLFS
U7: ESP32-S3-WROOM-1-N16R8; ESP32-S3-WROOM-1; MPN ESP32-S3-WROOM-1-N16R8
U8: LSM6DSL; LGA-14_3x2.5mm_P0.5mm_LayoutBorder3x4y; MPN LSM6DSLTR

Connections:
+3V3: C55.1, C56.1, C57.1, C58.1, C59.1, C60.1, J12.4 (VDD), J13.1, R34.1, R35.1, R38.1, R39.1, R40.1, R41.1, R42.1, R43.1, R44.1, R45.1, R50.2, U7.2 (3V3), U8.5 (VDDIO), U8.8 (VDD), U8.12 (CS); also elsewhere on the board
AFE_CS: U7.18 (IO10); also elsewhere on the board
AFE_DIN: U7.19 (IO11); also elsewhere on the board
AFE_DOUT: U7.21 (IO13); also elsewhere on the board
AFE_DRDY: U7.17 (IO9); also elsewhere on the board
AFE_EN_MCU: U7.25 (IO48); also elsewhere on the board
AFE_PWDN: U7.24 (IO47); also elsewhere on the board
AFE_RESET: U7.23 (IO21); also elsewhere on the board
AFE_SCLK: U7.20 (IO12); also elsewhere on the board
AFE_START: U7.22 (IO14); also elsewhere on the board
BOOT: R35.2, SW3.1, U7.27 (IO0)
ESP_EN: C54.1, R34.2, SW2.1, U7.3 (EN)
FG_ALRT: U7.7 (IO7); also elsewhere on the board
GND: C54.2, C55.2, C56.2, C57.2, C58.2, C59.2, C60.2, C61.2, C62.2, D2.1 (K), D3.1 (K), J12.6 (VSS), J12.10 (DET_A), J12.11 (SHIELD), J13.6, SW2.2, SW3.2, U7.1 (GND), U7.40 (GND), U7.41 (GND), U8.1 (SDO/SA0), U8.2 (SDX), U8.3 (SCX), U8.6 (GND), U8.7 (GND); also elsewhere on the board
I2C_SCL: R39.2, U7.5 (IO5), U8.13 (SCL); also elsewhere on the board
I2C_SDA: R38.2, U7.4 (IO4), U8.14 (SDA); also elsewhere on the board
IMU_INT1: U7.6 (IO6), U8.4 (INT1)
LEDB_A: D3.2 (A), R37.2
LEDG_A: D2.2 (A), R36.2
LED_B: R37.1, U7.11 (IO18)
LED_G: R36.1, U7.10 (IO17)
SD_CLK: J12.5 (CLK), U7.32 (IO39)
SD_CMD: J12.3 (CMD), R40.2, U7.31 (IO38)
SD_D0: J12.7 (DAT0), R41.2, U7.33 (IO40)
SD_D1: J12.8 (DAT1), R42.2, U7.34 (IO41)
SD_D2: J12.1 (DAT2), R43.2, U7.35 (IO42)
SD_D3: J12.2 (DAT3/CD), R44.2, U7.38 (IO2)
SD_DET: J12.9 (DET_B), R45.2, U7.39 (IO1)
TD_AN1: C61.1, J13.4, R48.2
TD_AN2: C62.1, J13.5, R49.2
TD_PWM1: R48.1, U7.9 (IO16)
TD_PWM2: R49.1, U7.12 (IO8)
TD_RX: J13.3, R47.1, R50.1
TD_RX_PIN: R47.2, U7.36 (RXD0)
TD_TX: J13.2, R46.2
TD_TX_PIN: R46.1, U7.37 (TXD0)
USB_D+: U7.14 (IO20); also elsewhere on the board
USB_D-: U7.13 (IO19); also elsewhere on the board
VBUS_DET: U7.8 (IO15); also elsewhere on the board

Notes on the sheet:
MCU: ESP32-S3 module, IMU, microSD, buttons, LEDs
ESP32-S3-WROOM-1-N16R8 (octal PSRAM: GPIO35-37 reserved). Strapping pins 0/3/45/46 left at defaults. AFE on SPI2 (GPIO9-14,21,47,48), microSD 4-bit SDMMC (GPIO1,2,38-42), I2C IMU + fuel gauge (GPIO4/5).
Terminal-device (prosthetic hand) interface: UART 115200 8N1 result packets + two filtered PWM proportional outputs (fc = 16 Hz). Outputs are disabled until the prosthetist enables them (firmware TD mode). Hand powered from its own battery.

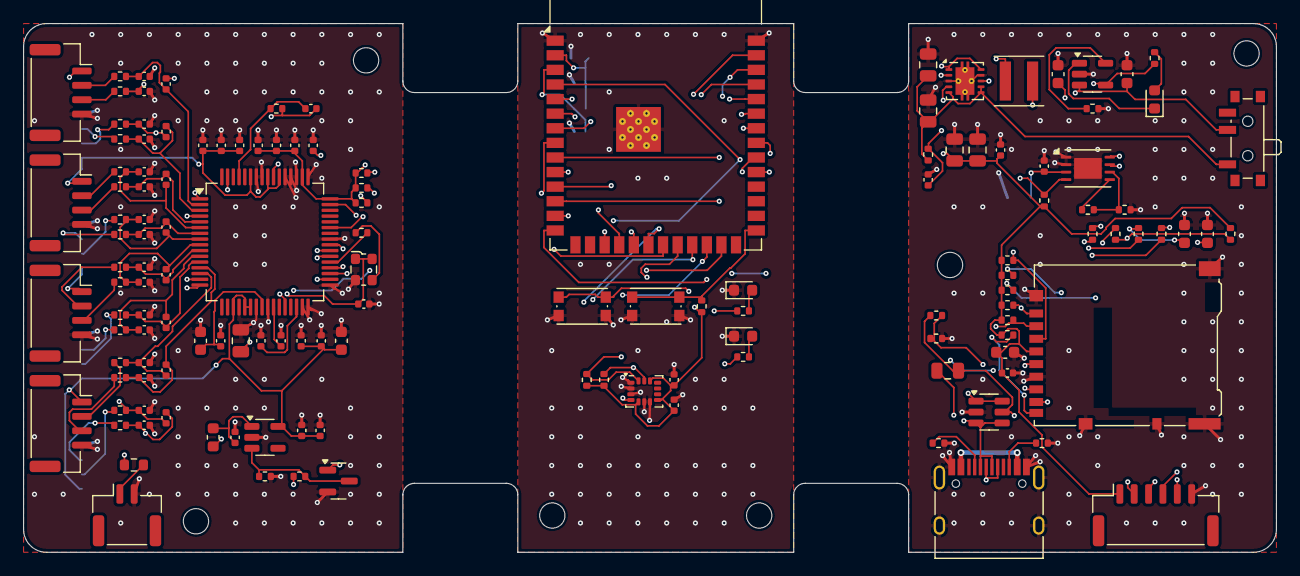
[picture p51: board hub_flex.kicad_pcb from above]

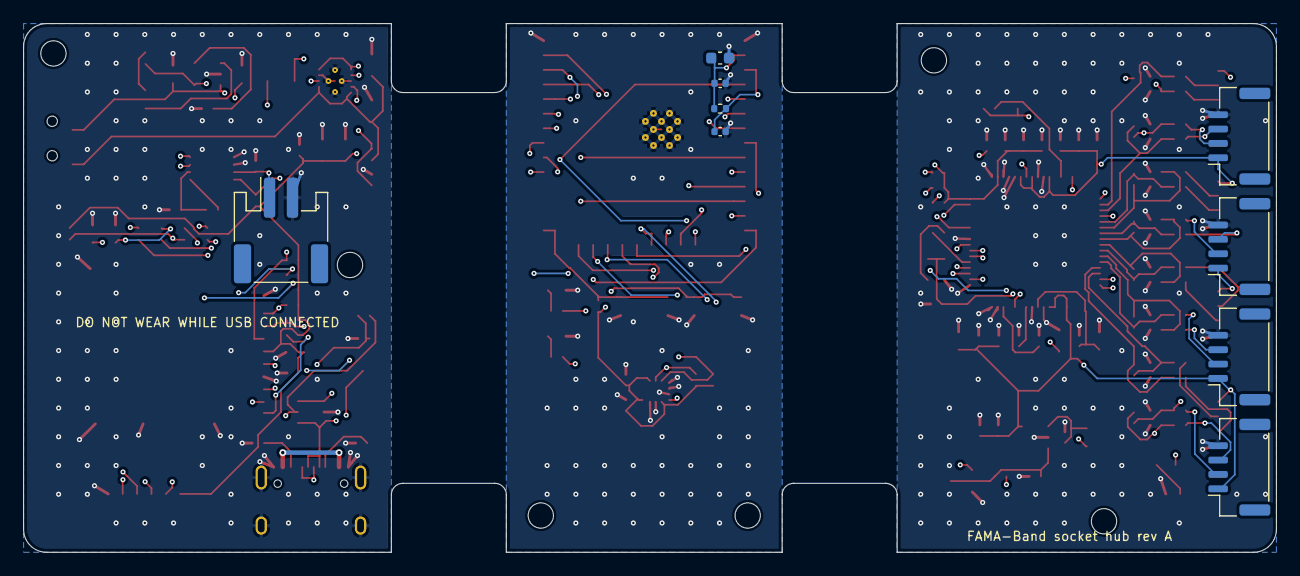
[picture p52: board hub_flex.kicad_pcb from below]

Board: 4 copper layers, 109.0 x 46.0 mm, 151 parts (9 on the bottom side), 98 nets.

Other parts of the board:
H1, H2, H3, H4, H5, H6: MountingHole_2.2mm_M2
