raulkovcs-ux/emg_iot_device/hardware/kicad/pod/pod.kicad_pcb

## KiCad design hardware/kicad/pod/pod.kicad_pcb (2026-10-24)

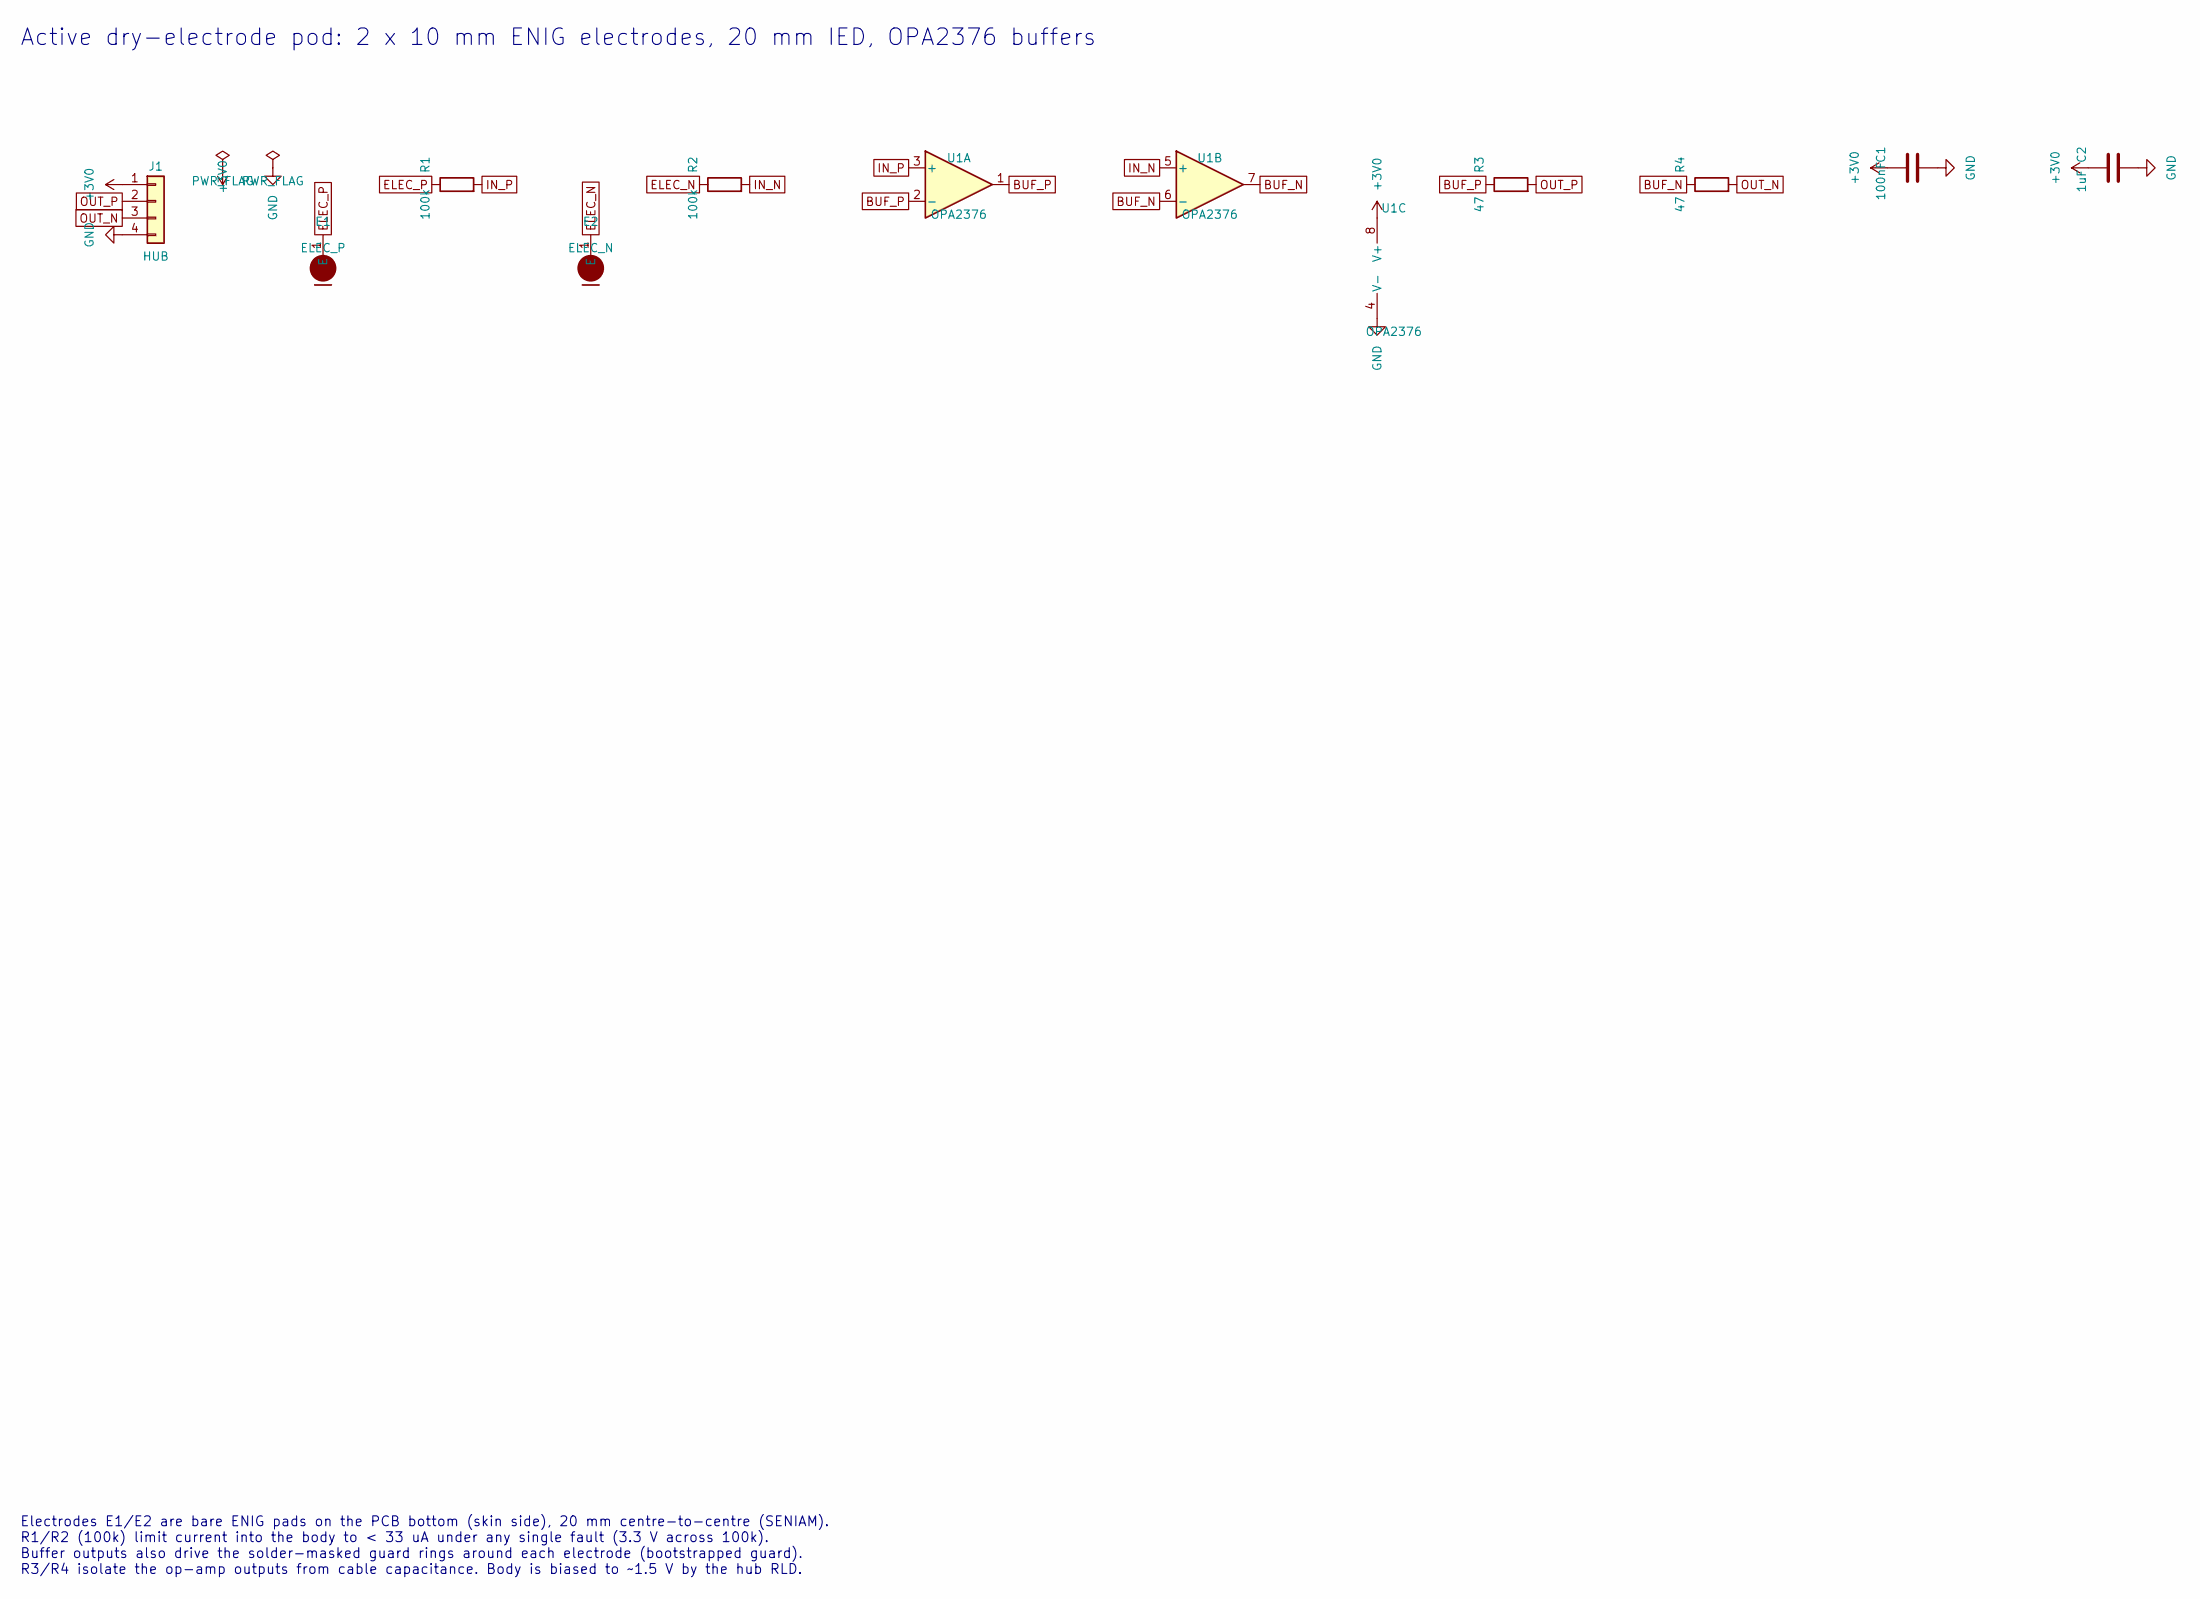
[picture p53: schematic pod.kicad_sch, FAMA-Band electrode pod - Active dry-electrode pod]

Parts:
C1: 100nF; C_0603_1608Metric
C2: 1uF; C_0603_1608Metric
E1: ELEC_P; DryElectrode_D10mm
E2: ELEC_N; DryElectrode_D10mm
J1: HUB; JST_GH_SM04B-GHS-TB_1x04-1MP_P1.25mm_Horizontal; MPN SM04B-GHS-TB(LF)(SN)
R1, R2: 100k; R_0603_1608Metric
R3, R4: 47; R_0603_1608Metric
U1: OPA2376; VSSOP-8_3.0x3.0mm_P0.65mm; MPN OPA2376AIDGKR

Connections:
+3V0: C1.1, C2.1, J1.1, U1.8 (V+)
BUF_N: R4.1, U1.6 (-), U1.7
BUF_P: R3.1, U1.1, U1.2 (-)
ELEC_N: E2.1, R2.1
ELEC_P: E1.1, R1.1
GND: C1.2, C2.2, J1.4, U1.4 (V-)
IN_N: R2.2, U1.5 (+)
IN_P: R1.2, U1.3 (+)
OUT_N: J1.3, R4.2
OUT_P: J1.2, R3.2

Notes on the sheet:
Active dry-electrode pod: 2 x 10 mm ENIG electrodes, 20 mm IED, OPA2376 buffers
Electrodes E1/E2 are bare ENIG pads on the PCB bottom (skin side), 20 mm centre-to-centre (SENIAM). R1/R2 (100k) limit current into the body to < 33 uA under any single fault (3.3 V across 100k). Buffer outputs also drive the solder-masked guard rings around each electrode (bootstrapped guard). R3/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

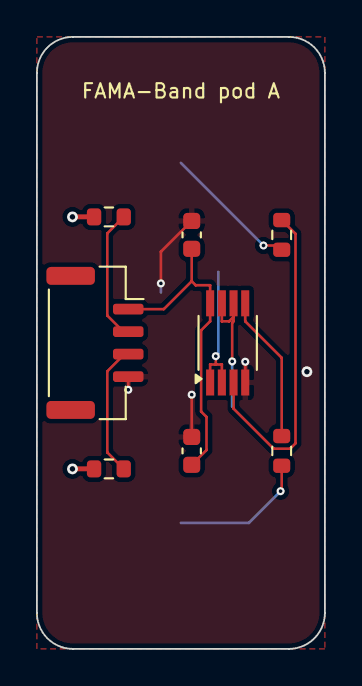
[picture p54: board pod.kicad_pcb from above]

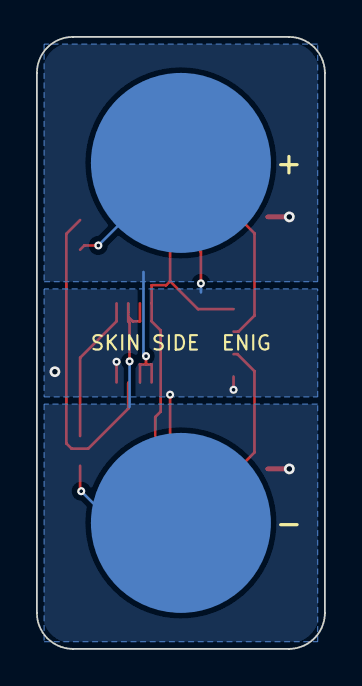
[picture p55: board pod.kicad_pcb from below]

Board: 2 copper layers, 16.0 x 34.0 mm, 10 parts (2 on the bottom side), 10 nets.
