raulkovcs-ux/emg_iot_device/(commit log)

2026-10-24 Add FAMA-Band: 8-channel sEMG armband for the FAMA-Net thesis
    Complete end-user device design for running FAMA-Net on a person:
    - docs: research and design rationale, numbered specification traced to
    the thesis review sheet, hardware design (noise, power, safety numbers),
    mechanics, firmware, safety/ethics, bring-up, wearing/session protocol
    - hardware: Python netlist -> KiCad 7 schematics (ERC clean, KiCad
    netlist matches source), hub PCB (4 layers, ADS1298 + ESP32-S3,
    DRC 0 errors / 0 unconnected) and active dry-electrode pod PCB
    (2 layers, ENIG, guarded electrodes), Gerbers, BOM, pick-and-place, STEP.
    Corrects the KiCad 7.0 ADS1298 symbol (pins 3/4 swapped).
    - mechanical: par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
    [afe.kicad_sch, famaband.scad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]
2026-10-25 Add prosthetic-socket variant with rigid-flex hub and hand interface
    - hardware: socket hub = armband hub circuit + terminal-device interface
    (UART + two filtered PWM proportional outputs). New 4-layer rigid-flex
    board hub_flex: three rigid islands (AFE / ESP32-S3 / power+IO) joined
    by two polyimide hinges that wrap 120 deg around the socket. Flex rules
    enforced in the generator: no parts/outer copper/vias in hinges, via
    keep-out 1.3 mm at transitions, locked straight In2 lanes perpendicular
    to the bend, hatched GND on In1, filleted junctions; router barred from
    the hinges. DRC: 0 errors, 0 unconnected. Fab drawing PDF added.
    - mechanical: parametric transradial socket (socket.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
    [afe.kicad_sch, hub.kicad_sch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]
